Les-opossums/ELE_PAMI_2027/3D/PAMI_2026_B1.step

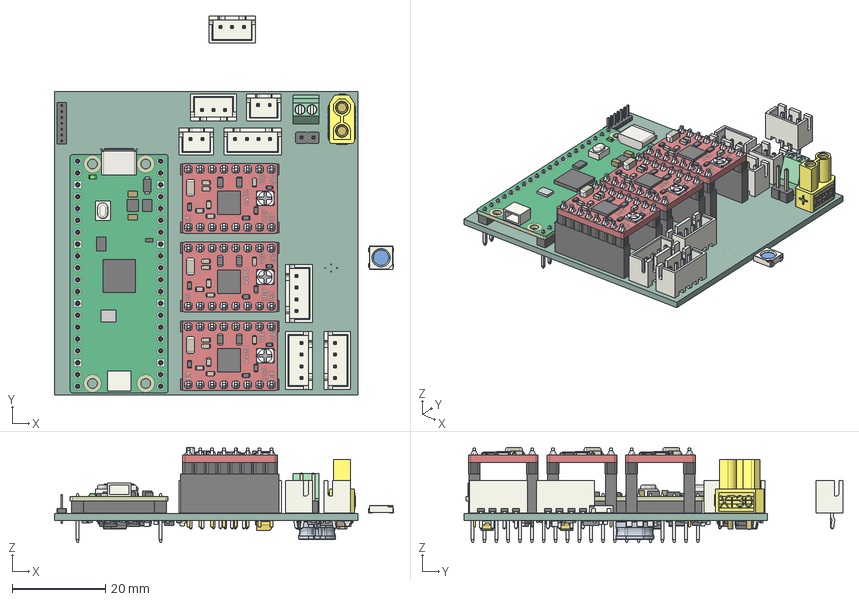
[picture p4: CAD file, 2026-11-06]
3D/PAMI_2026_B1.step
72.7 x 81.2 x 20.4 mm
PinHeader_1x07_P1.27mm_Vertical
XT30-F_m.ver
JST_XH_B4B-XH-A_1x04_P2.50mm_Vertical x 4
A4988-Stepper-Driver-Socketed x 3
JST_XH_B2B-XH-A_1x02_P2.50mm_Vertical x 2
TerminalBlock_Phoenix_MPT-0,5-2-2.54_1x02_P2.54mm_Horizontal
LED_WS2812B_PLCC4_5.0x5.0mm_P3.2mm
RaspberryPi_Pico_H_Module_KiCad
RaspberryPi_Pico_Header_DIP-40_H2.54mm_KiCad
PinHeader_1x02_P2.54mm_Vertical
JST_XH_B3B-XH-A_1x03_P2.50mm_Vertical x 2
MOLD x 2
C_CASE-B-3528-21(mm) x 3
C_0805 x 6
R_0402 x 40
R_0603 x 7
C_0603 x 5
C_0402 x 9
SMAF_L3.5-W2.6-LS4.7-RD
Q_SOT-23 x 5
LED_0603_1608Metric x 4
BODY-QFN
PIN1-ID
SRN8040
SOIC-8_3.9x4.9mm_P1.27mm
SOT-223_L6.5-W3.5-P2.30-LS7.0-BR
PAMI_2026_B1_PCB
