Les-opossums/ELE_PAMI_2027/_Design/WBDesign15.pdf

## WEBENCH ® Design Report

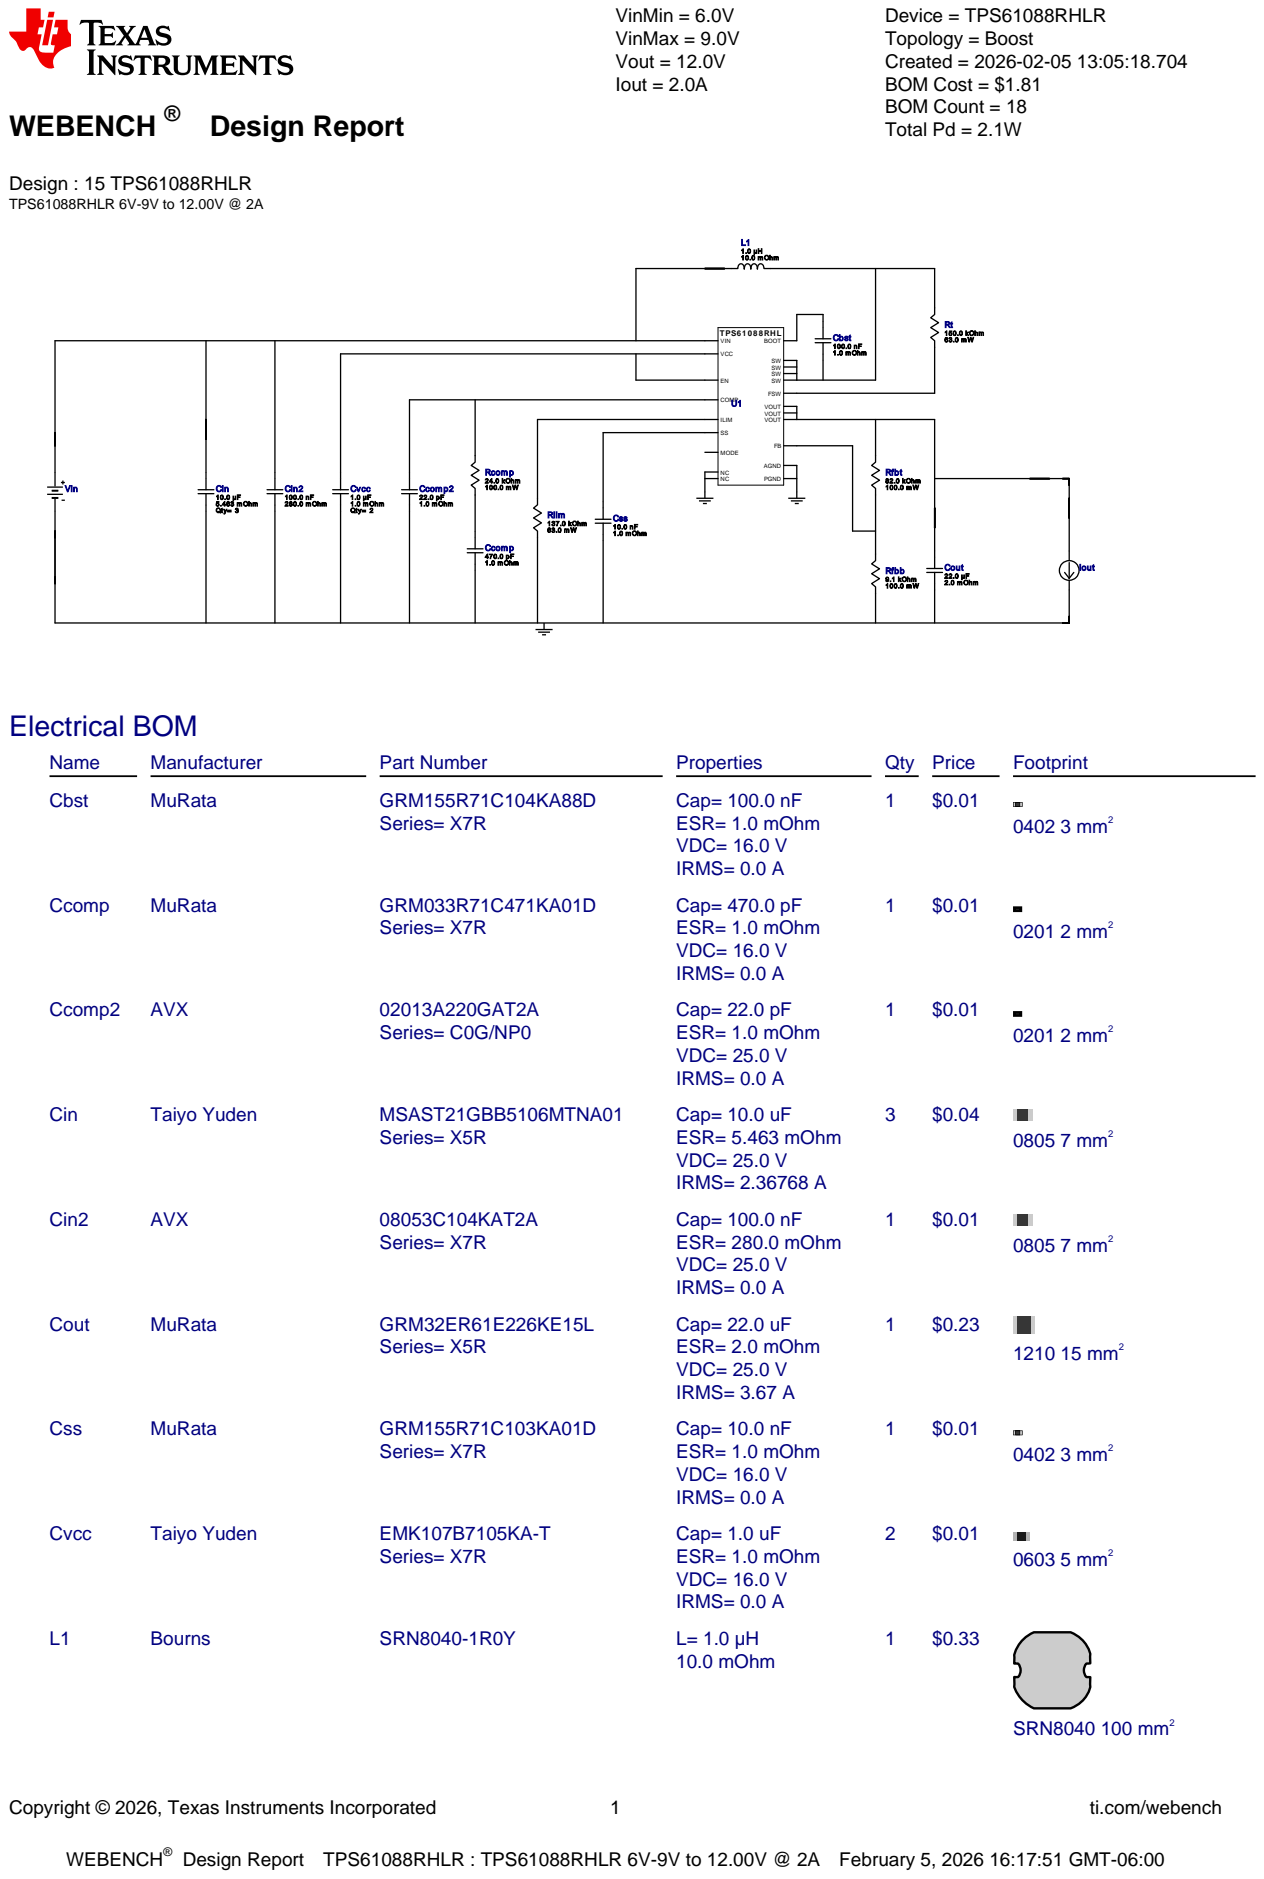
[picture p5: page 1]
Copyright © 2026, Texas Instruments Incorporated; ti.com/webench; WEBENCH®; Design : 15 TPS61088RHLR TPS61088RHLR 6V-9V to 12.00V @ 2A; VinMin = 6.0V VinMax = 9.0V Vout = 12.0V Iout = 2.0A; Device = TPS61088RHLR Topology = Boost Created = 2026-02-05 13:05:18.704 BOM Cost = $1.81 BOM Count = 18 Total Pd = 2.1W; Rlim 137.0 kOhm 63.0 m W; Ccom p 470.0 pF 1.0 m Ohm; Cin2 100.0 nF 280.0 m Ohm; TPS6 1 0 8 8 RHL; VCC; FSW; VIN; BOOT; MODE; VOUT VOUT VOUT; COMP; ILIM; AGND; PGND; Rfbt 82.0 kOhm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

Design Report TPS61088RHLR : TPS61088RHLR 6V-9V to 12.00V @ 2A February 5, 2026 16:17:51 GMT-06:00

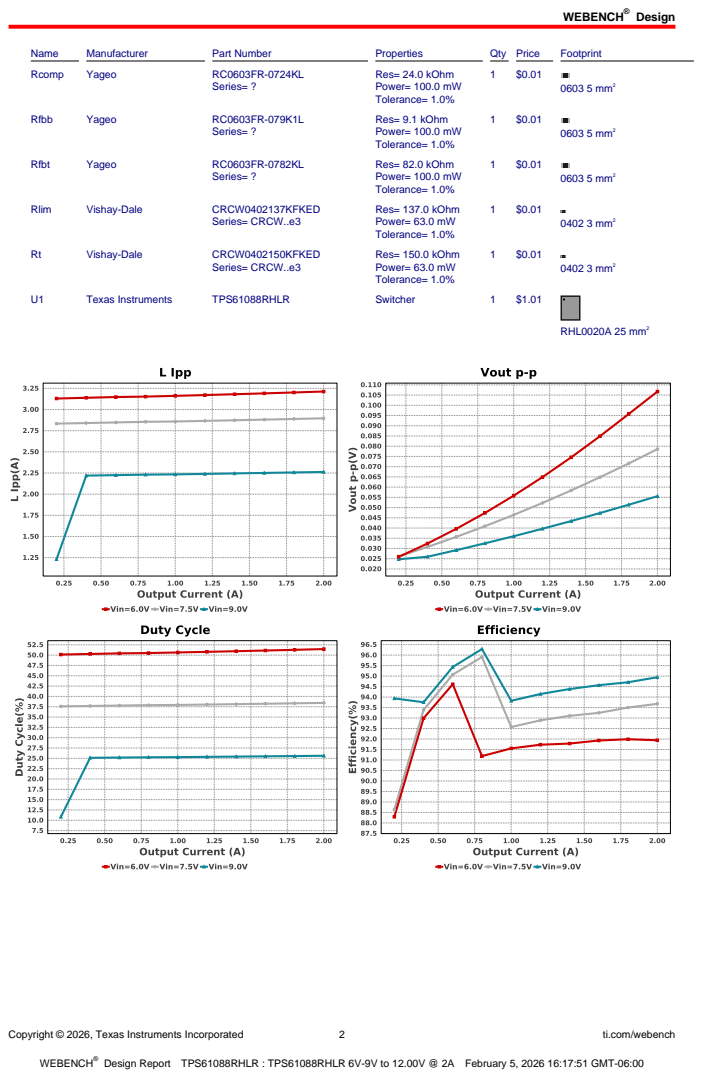
[picture p6: page 2]
Design; Copyright © 2026, Texas Instruments Incorporated; ti.com/webench; Name; Manufacturer; Part Number; Properties; Qty Price; Footprint; Rcomp; Yageo; Series= ?; Res= 24.0 kOhm Power= 100.0 mW Tolerance= 1.0%; 0603 5 mm²; Rfbb; Res= 9.1 kOhm Power= 100.0 mW Tolerance= 1.0%; Rfbt; Res= 82.0 kOhm Power= 100.0 mW Tolerance= 1.0%; Rlim; Vishay-Dale; CRCW0402137KFKED; Series= CRCW..e3; Res= 137.0 kOhm Power= 63.0 mW Tolerance= 1.0%; 0402 3 mm²; CRCW0402150KFKED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

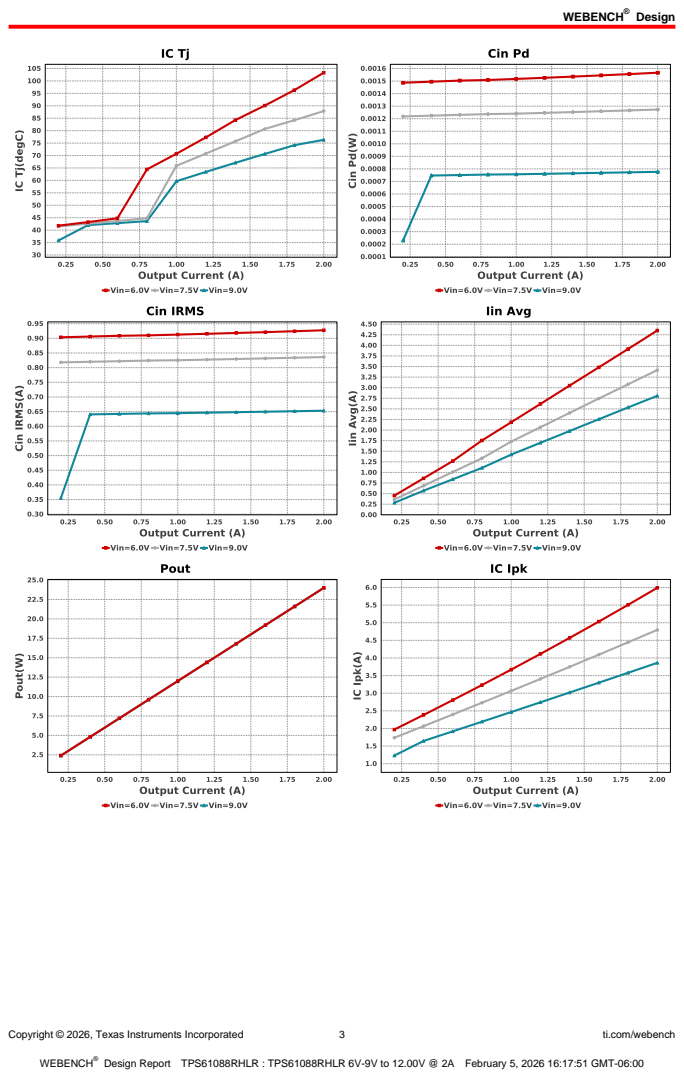
[picture p7: page 3]
Copyright © 2026, Texas Instruments Incorporated; ti.com/webench

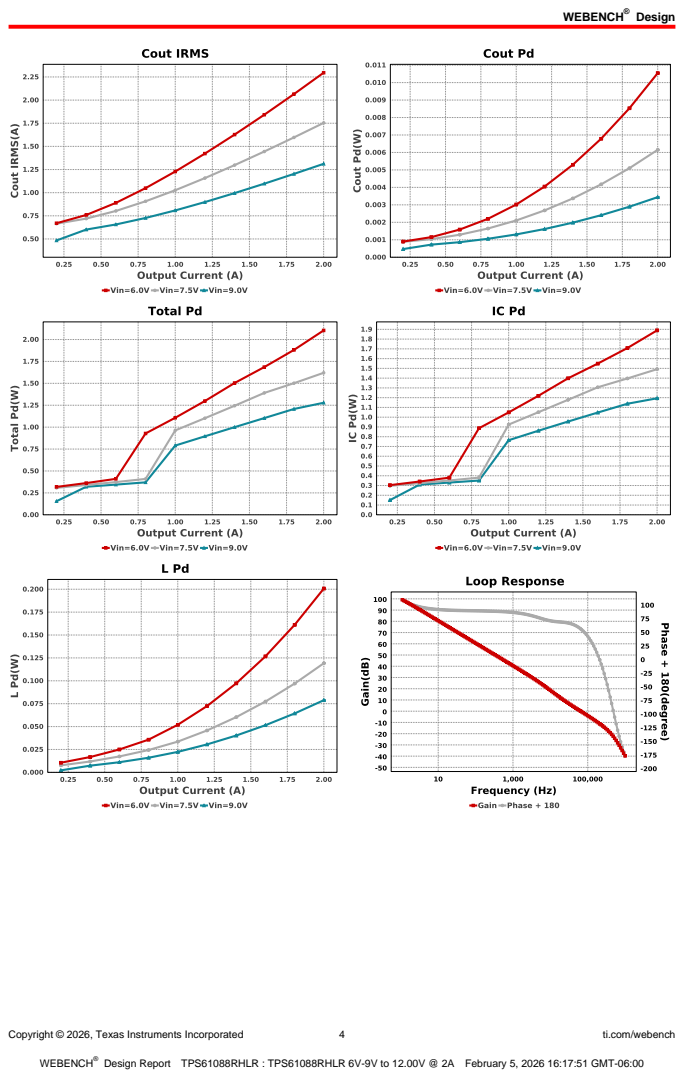
[picture p8: page 4]
Copyright © 2026, Texas Instruments Incorporated; ti.com/webench

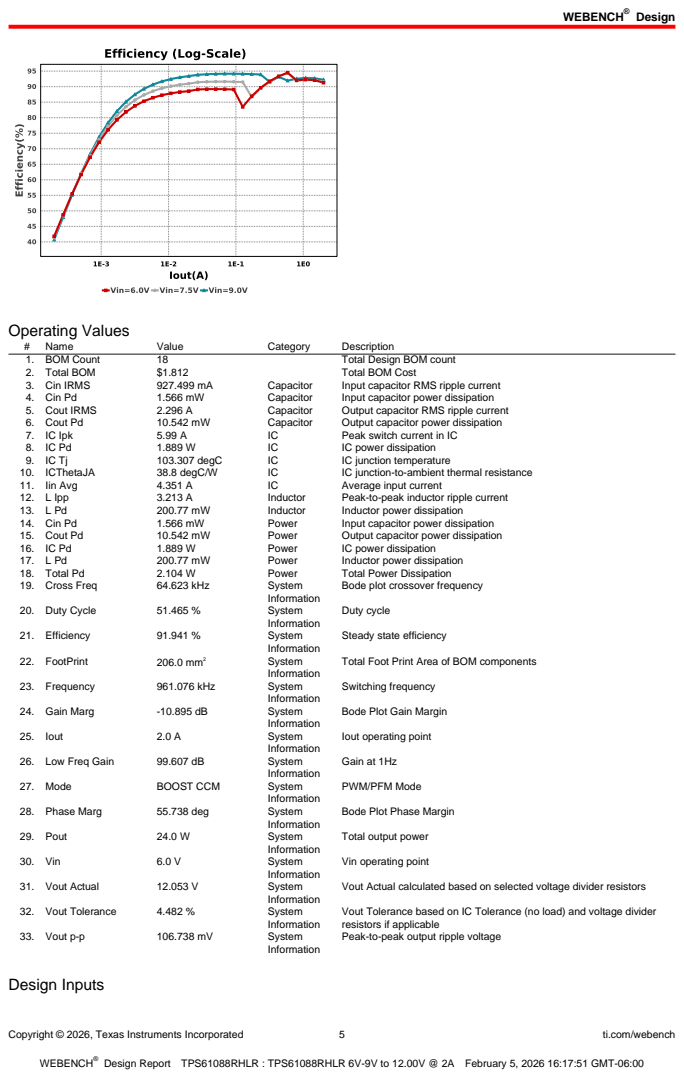
[picture p9: page 5]
Copyright © 2026, Texas Instruments Incorporated; ti.com/webench; Operating Values; Name; Value; Category; Description; 1. BOM Count; Total Design BOM count; 2. Total BOM; Total BOM Cost; 3. Cin IRMS; Capacitor; Input capacitor RMS ripple current; 4. Cin Pd; Input capacitor power dissipation; 5. Cout IRMS; Output capacitor RMS ripple current; 6. Cout Pd; Output capacitor power dissipation; 7. IC Ipk; Peak switch current in IC; IC power dissipation; 103.307 degC; IC junction temperature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

Bode plot crossover frequency

Steady state efficiency

Total Foot Print Area of BOM components

Bode Plot Gain Margin

Iout operating point

PWM/PFM Mode

Bode Plot Phase Margin

Total output power

Vin operating point

Vout Actual calculated based on selected voltage divider resistors

Vout Tolerance based on IC Tolerance (no load) and voltage divider
resistors if applicable
Peak-to-peak output ripple voltage

Copyright © 2026, Texas Instruments Incorporated | 6 | ti.com/webench
Name | Value | Description
Iout | 2.0 | Maximum Output Current
SoftStart | 2.41 ms | Soft Start Time (ms)
VinMax | 9.0 | Maximum input voltage
VinMin | 6.0 | Minimum input voltage
Vout | 12.0 | Output Voltage
base_pn | TPS61088 | Base Product Number
source | DC | Input Source Type
Ta | 30.0 | Ambient temperature
UserFsw | 961.0 k | Customer Selected Frequency


Copyright © 2026, Texas Instruments Incorporated | 7 | ti.com/webench

## Assembly

## Component Testing

Some published data on components in datasheets such as Capacitor ESR and Inductor DC resistance is based on conservative values that will guarantee that the components always exceed the specification. For design purposes it is usually better to work with typical values. Since this data is not always available it is a good practice to measure the Capacitance and ESR values of Cin and Cout, and the inductance and DC resistance of L1 before assembly of the board. Any large discrepancies in values should be electrically simulated in WEBENCH to check for instabilities and thermally simulated in WebTHERM to make sure critical temperatures are not exceeded.

## Soldering Component to Board

If board assembly is done in house it is best to tack down one terminal of a component on the board then solder the other terminal. For surface mount parts with large tabs, such as the DPAK, the tab on the back of the package should be pre-tinned with solder, then tacked into place by one of the pins. To solder the tab town to the board place the iron down on the board while resting against the tab, heating both surfaces simultaneously. Apply light pressure to the top of the plastic case until the solder flows around the part and the part is flush with the PCB. If the solder is not flowing around the board you may need a higher wattage iron (generally 25W to 30W is enough).

## Initial Startup of Circuit

It is best to initially power up the board by setting the input supply voltage to the lowest operating input voltage 6.0V and set the input supply's current limit to zero. With the input supply off connect up the input supply to Vin and GND. Connect a digital volt meter and a load if needed to set the minimum Iout of the design from Vout and GND. Turn on the input supply and slowly turn up the current limit on the input supply. If the voltage starts to rise on the input supply continue increasing the input supply current limit while watching the output voltage. If the current increases on the input supply, but the voltage remains near zero, then there may be a short or a component misplaced on the board. Power down the board and visually inspect for solder bridges and recheck the diode and capacitor polarities. Once the power supply circuit is operational then more extensive testing may include full load testing, transient load and line tests to compare with simulation results.

## Load Testing

The setup is the same as the initial startup, except that an additional digital voltmeter is connected between Vin and GND, a load is connected between Vout and GND and a current meter is connected in series between Vout and the load. The load must be able to handle at least rated output power + 50% ( 7.5 watts for this design). Ideally the load is supplied in the form of a variable load test unit. It can also be done in the form of suitably large power resistors. When using an oscilloscope to measure waveforms on the prototype board, the ground leads of the oscilloscope probes should be as short as possible and the area of the loop formed by the ground lead should be kept to a minimum. This will help reduce ground lead inductance and eliminate EMI noise that is not actually present in the circuit.

## Design Assistance

1. Master key : A334E1D4DAA32D88[v1]
2. TPS61088 Product Folder : http://www.ti.com/product/TPS61088 : contains the data sheet and other resources.

Copyright © 2026, Texas Instruments Incorporated | 8 | ti.com/webench

Important Notice and Disclaimer

TI provides technical and reliability data (including datasheets), design resources (including reference designs), application or other design advice, web tools, safety information, and other resources AS IS and with all faults, and disclaims all warranties. These resources are intended for skilled developers designing with TI products. You are solely responsible for (1) selecting the appropriate TI products for your application, (2) designing, validating and testing your application, and (3) ensuring your application meets applicable standards, and any other safety, security, or other requirements.

These resources are subject to change without notice. TI grants you permission to use these resources only for development of an application that uses the TI products described in the resource. Other reproduction and display of these resources is prohibited. No license is granted to any other TI intellectual property right or to any third party intellectual property right. TI disclaims responsibility for, and you will fully indemnify TI and its representatives against, any claims, damages, costs, losses, and liabilities arising out of your use of these resources.

Providing these resources does not expand or otherwise alter TI's applicable Terms of Sale or other applicable terms available either on ti.com or provided in conjunction with TI products.
