Les-opossums/ELE_PAMI_2027/PAMI_2027_A1.pdf

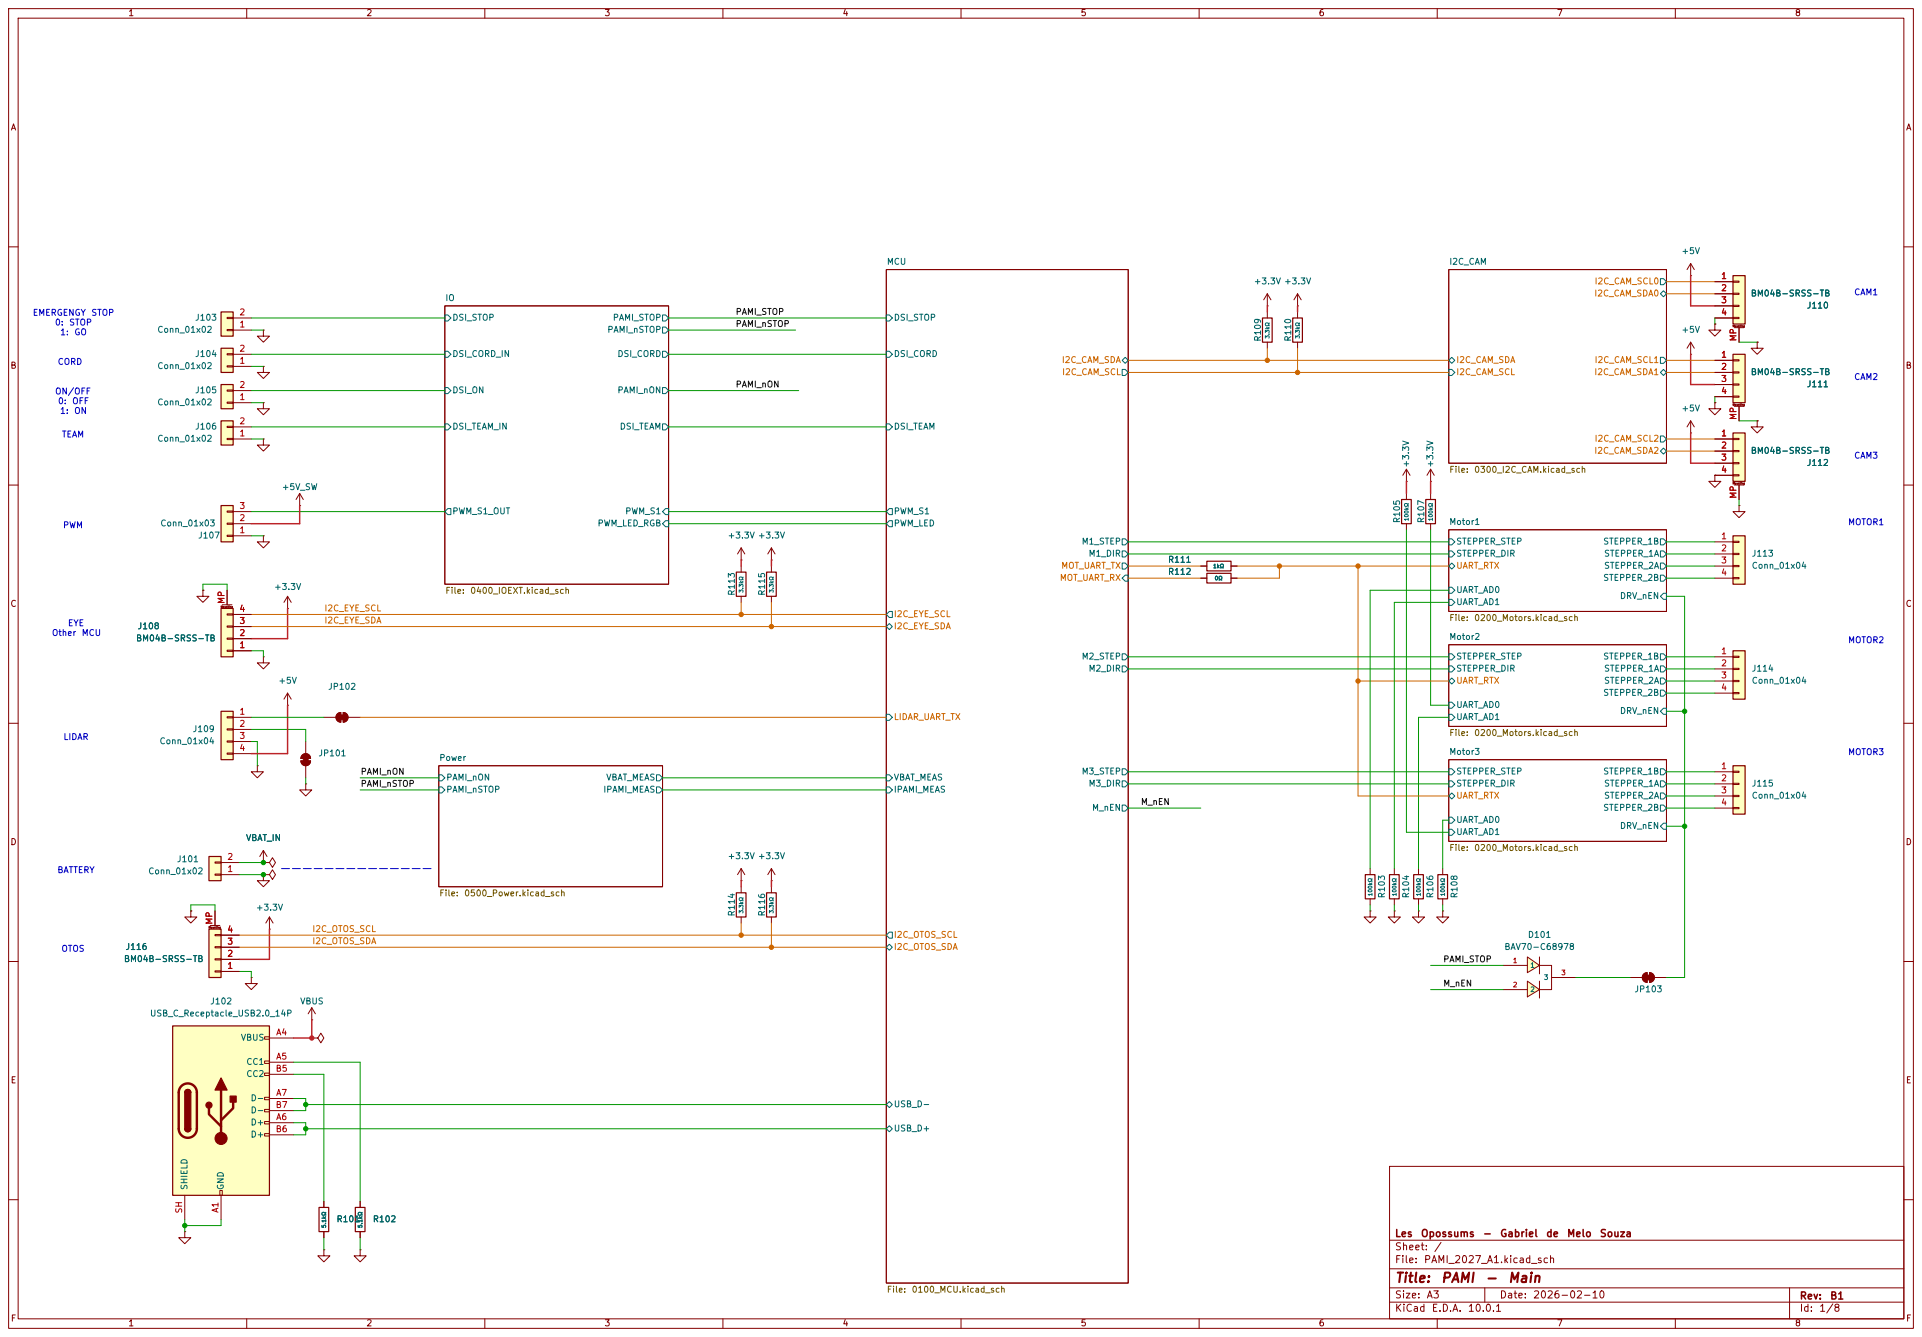
[picture p11: page 1]

1 | PAMI_nON | +3.3V 1

2 2
3 3

Les Opossums - Gabriel de Melo Souza
Sheet: /
File: PAMI_2027_A1.kicad_sch
Title: PAMI - Main

Size: A3 | Rev: B1 | F Date: 2026-02-10
KiCad E.D.A. 10.0.1 | Id: 1/8

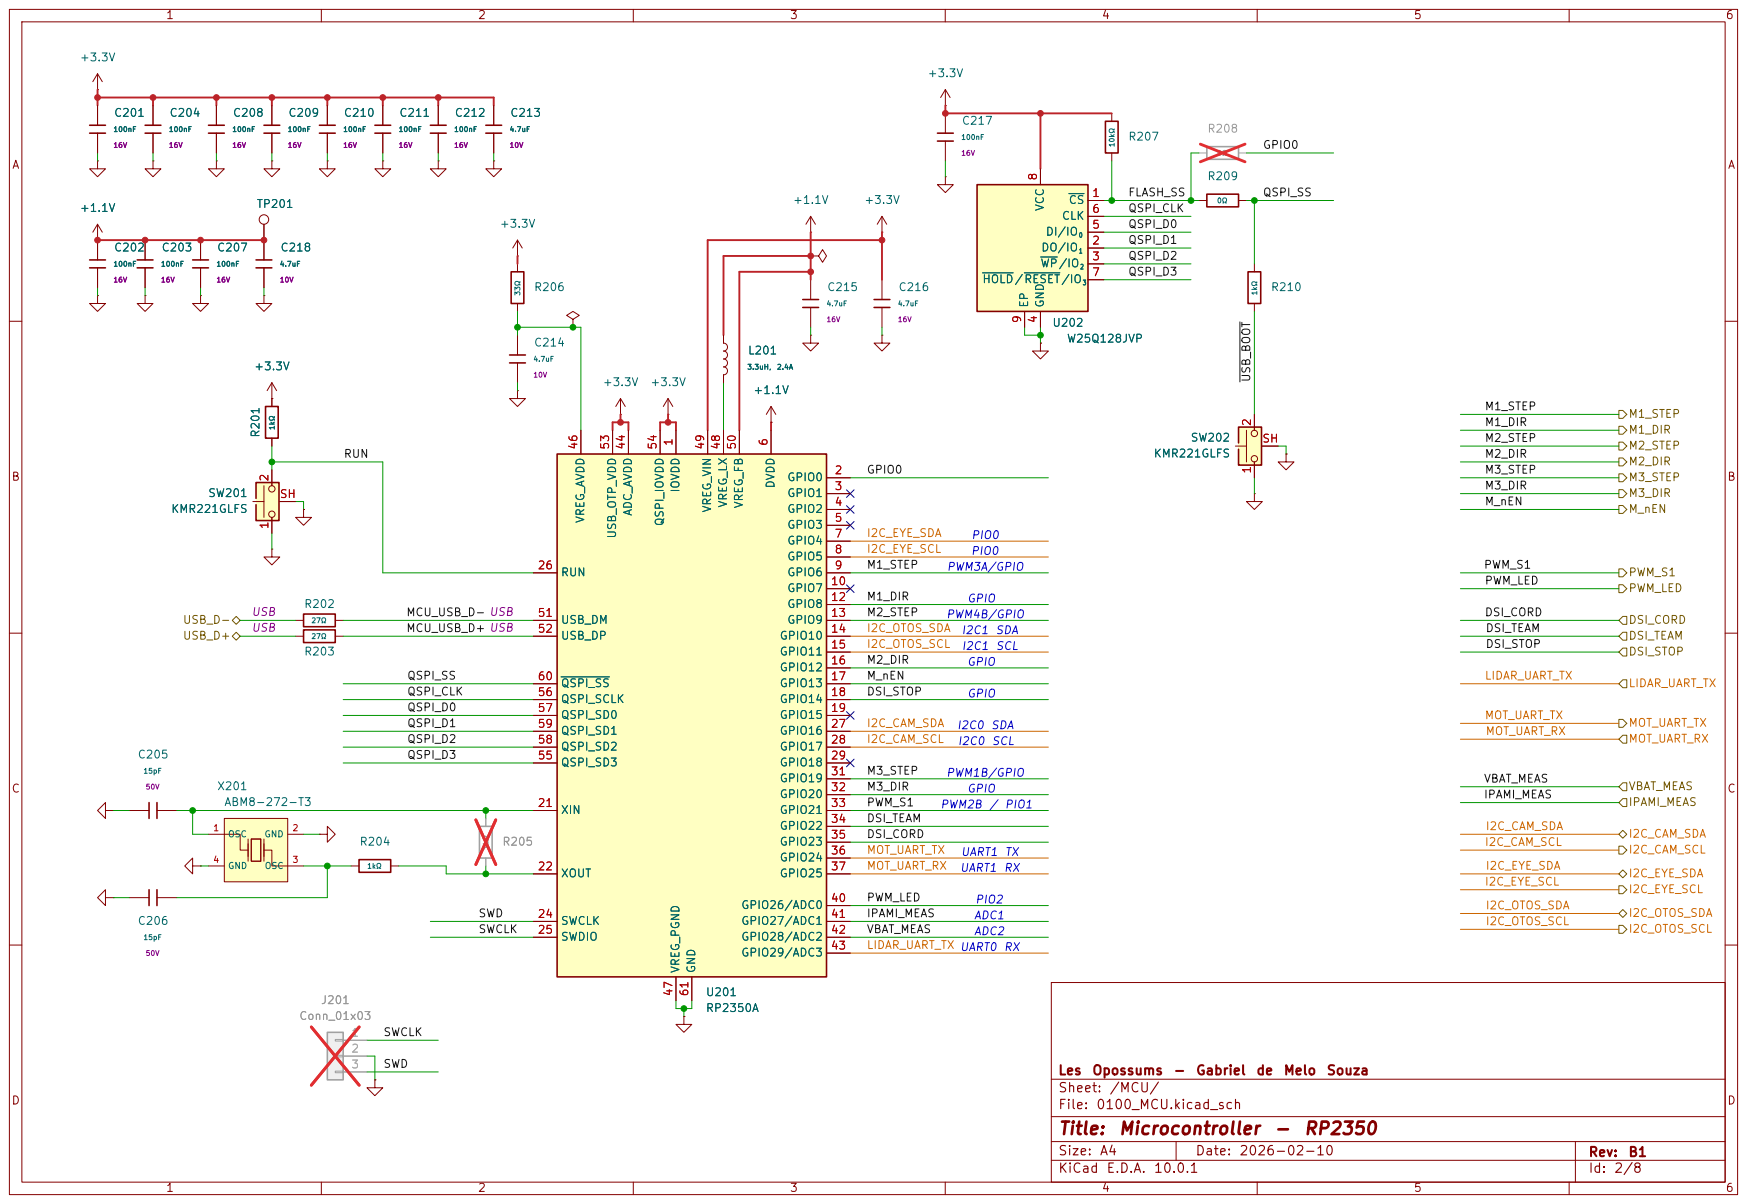
[picture p12: page 2]

4 DI/IO0 5 CLK 6 HOLD/RESET/IO3 7 VCC

XIN 21

XOUT 22 XOUT 22 SWCLK 24 SWCLK 24

Les Opossums - Gabriel de Melo Souza
Sheet: /MCU/
File: 0100_MCU.kicad_sch
Title: Microcontroller - RP2350

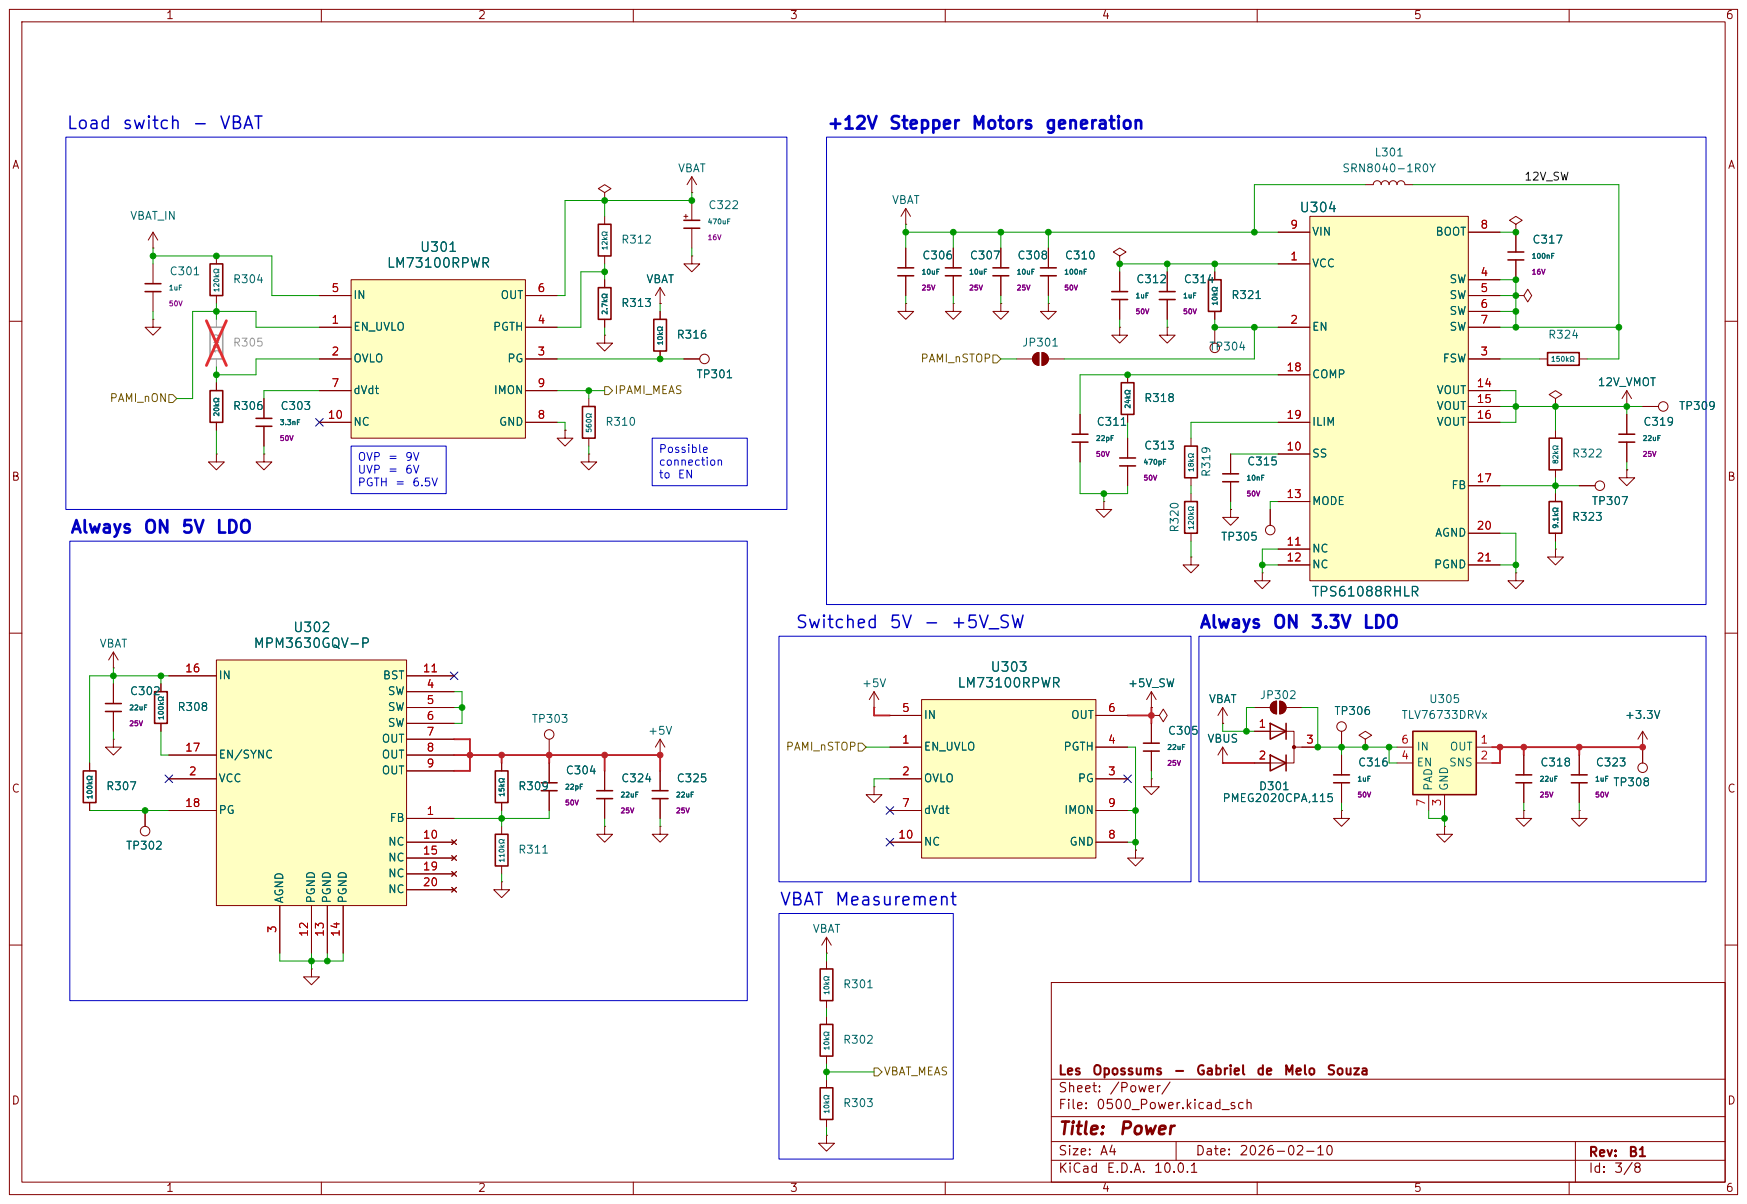
[picture p13: page 3]

VCC 1

to EN Always ON 5V LDO

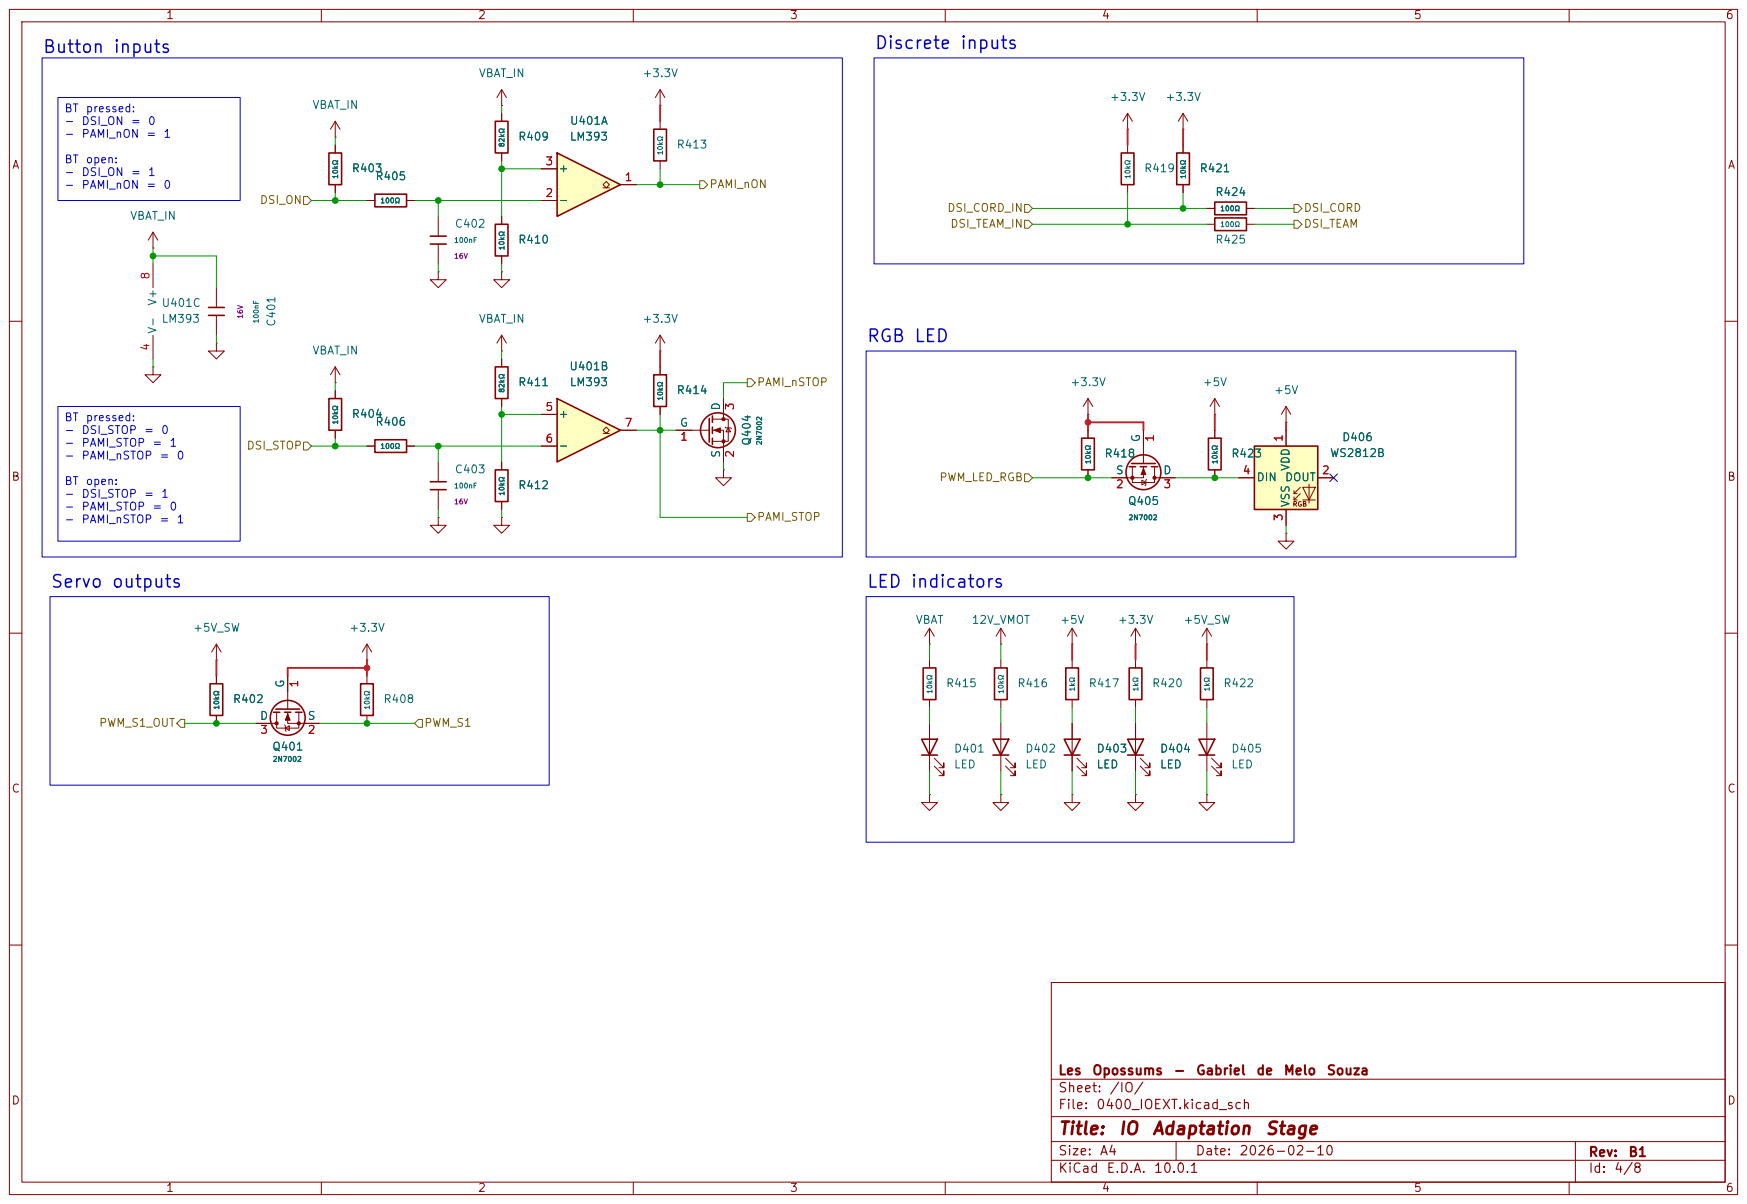
[picture p14: page 4]

Sheet: /IO/
File: 0400_IOEXT.kicad_sch
Title: IO Adaptation Stage

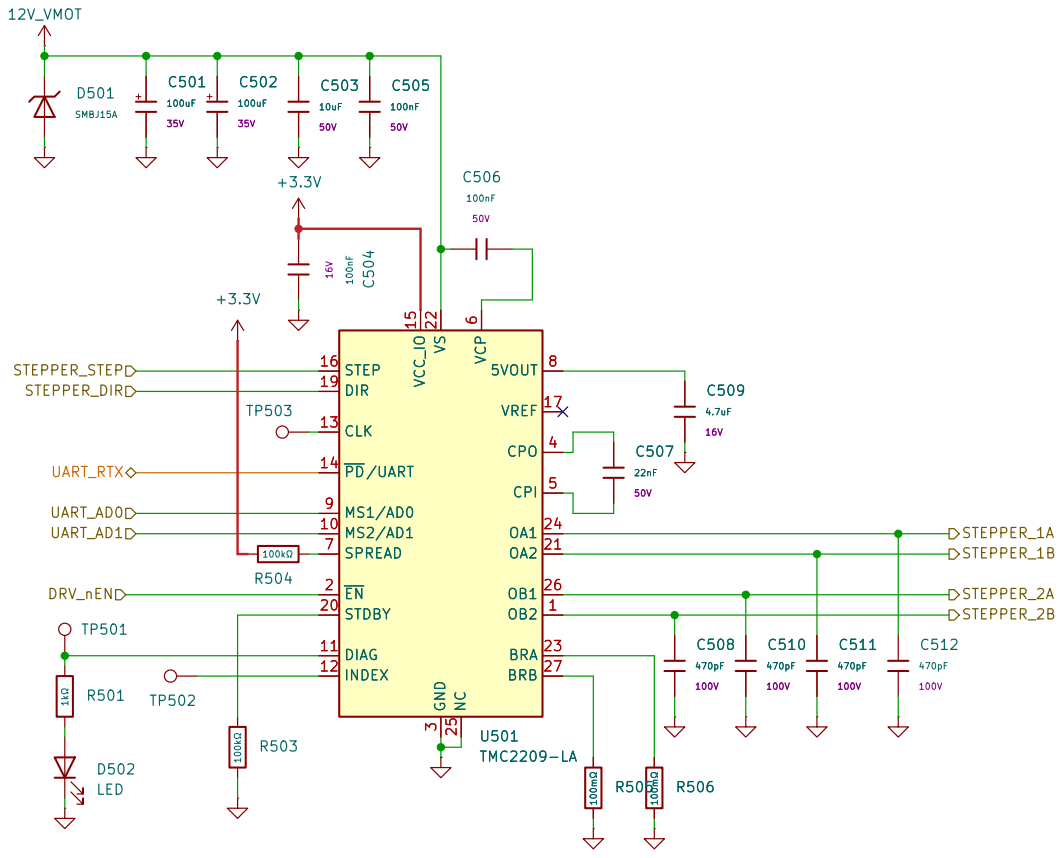
[picture p15: page 5]

Les Opossums - Gabriel de Melo Souza
Sheet: /Motor1/
File: 0200_Motors.kicad_sch
Title: Stepper Motor

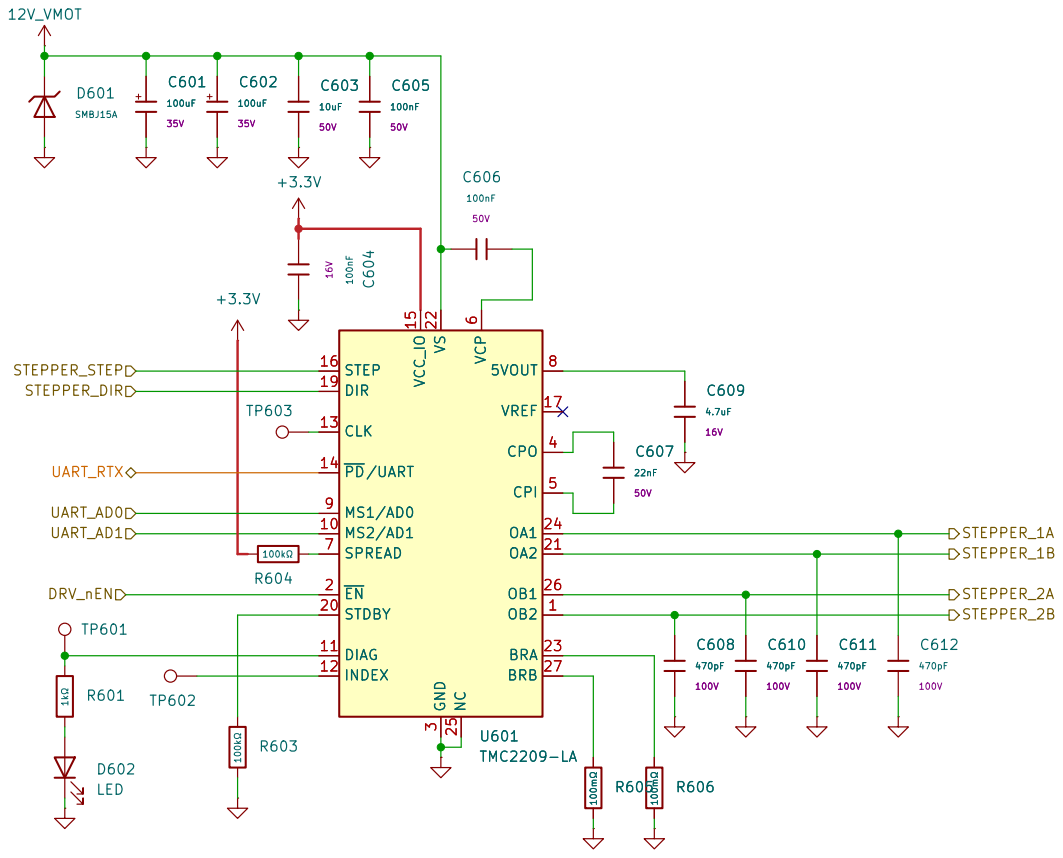
[picture p16: page 6]

Les Opossums - Gabriel de Melo Souza
Sheet: /Motor2/
File: 0200_Motors.kicad_sch
Title: Stepper Motor

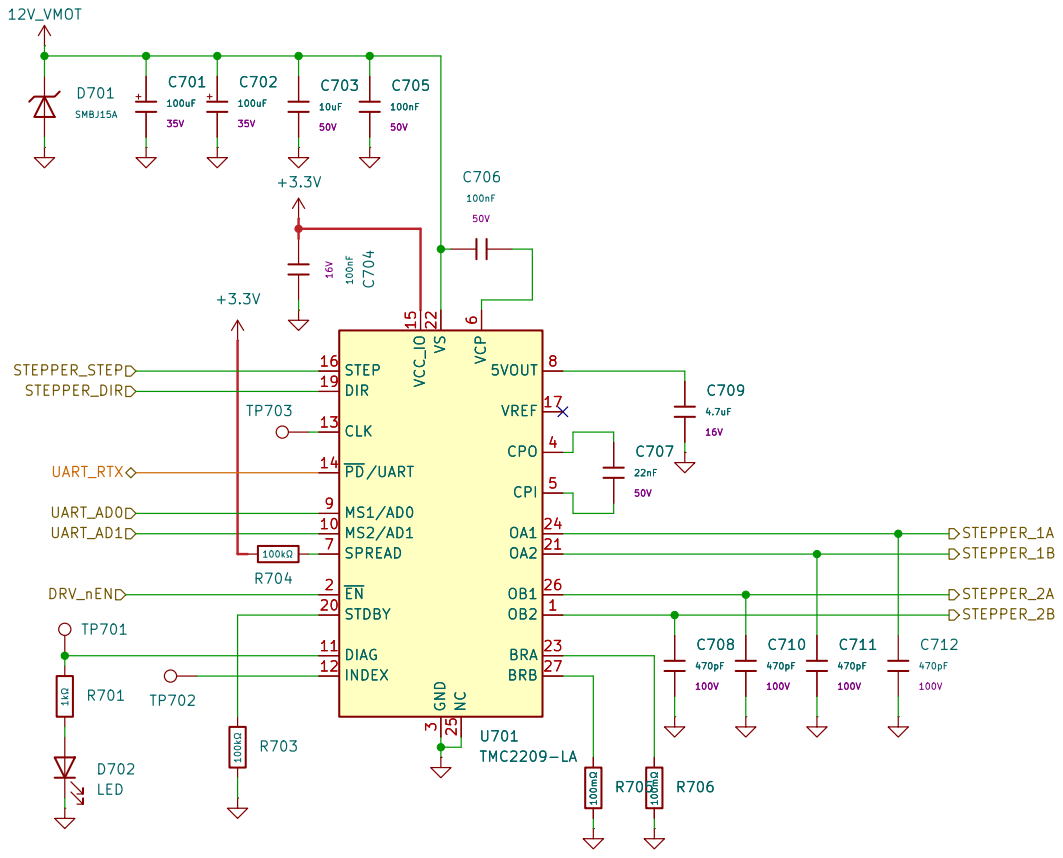
[picture p17: page 7]

Les Opossums - Gabriel de Melo Souza
Sheet: /Motor3/
File: 0200_Motors.kicad_sch
Title: Stepper Motor

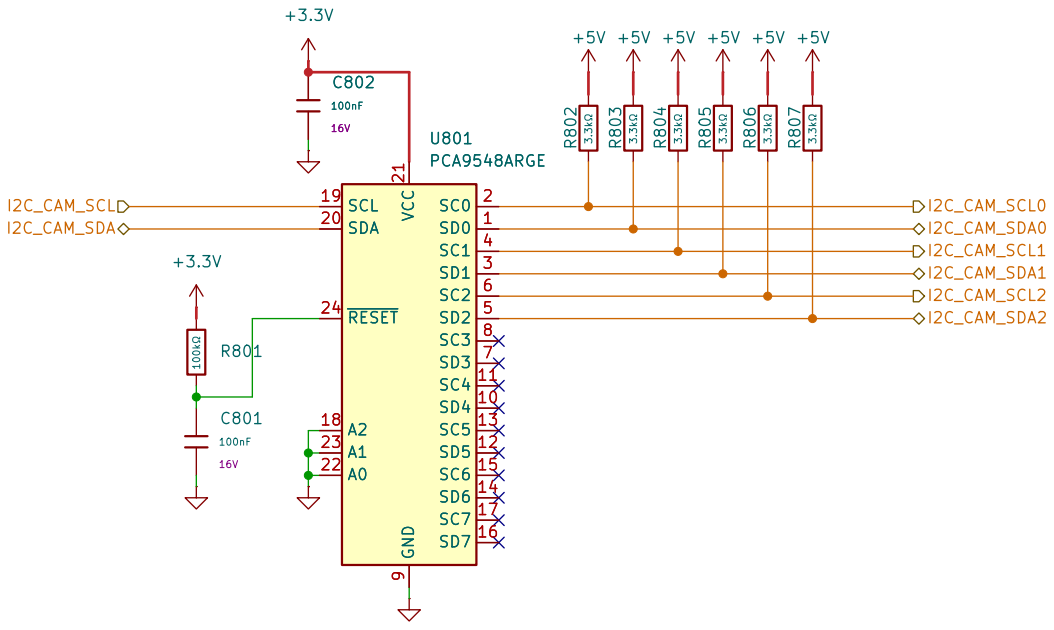
[picture p18: page 8]
