Les-opossums/ELE_PAMI_2027/PAMI_2027_A1.kicad_pcb

## KiCad design PAMI_2027_A1.kicad_pcb (2026-11-06)

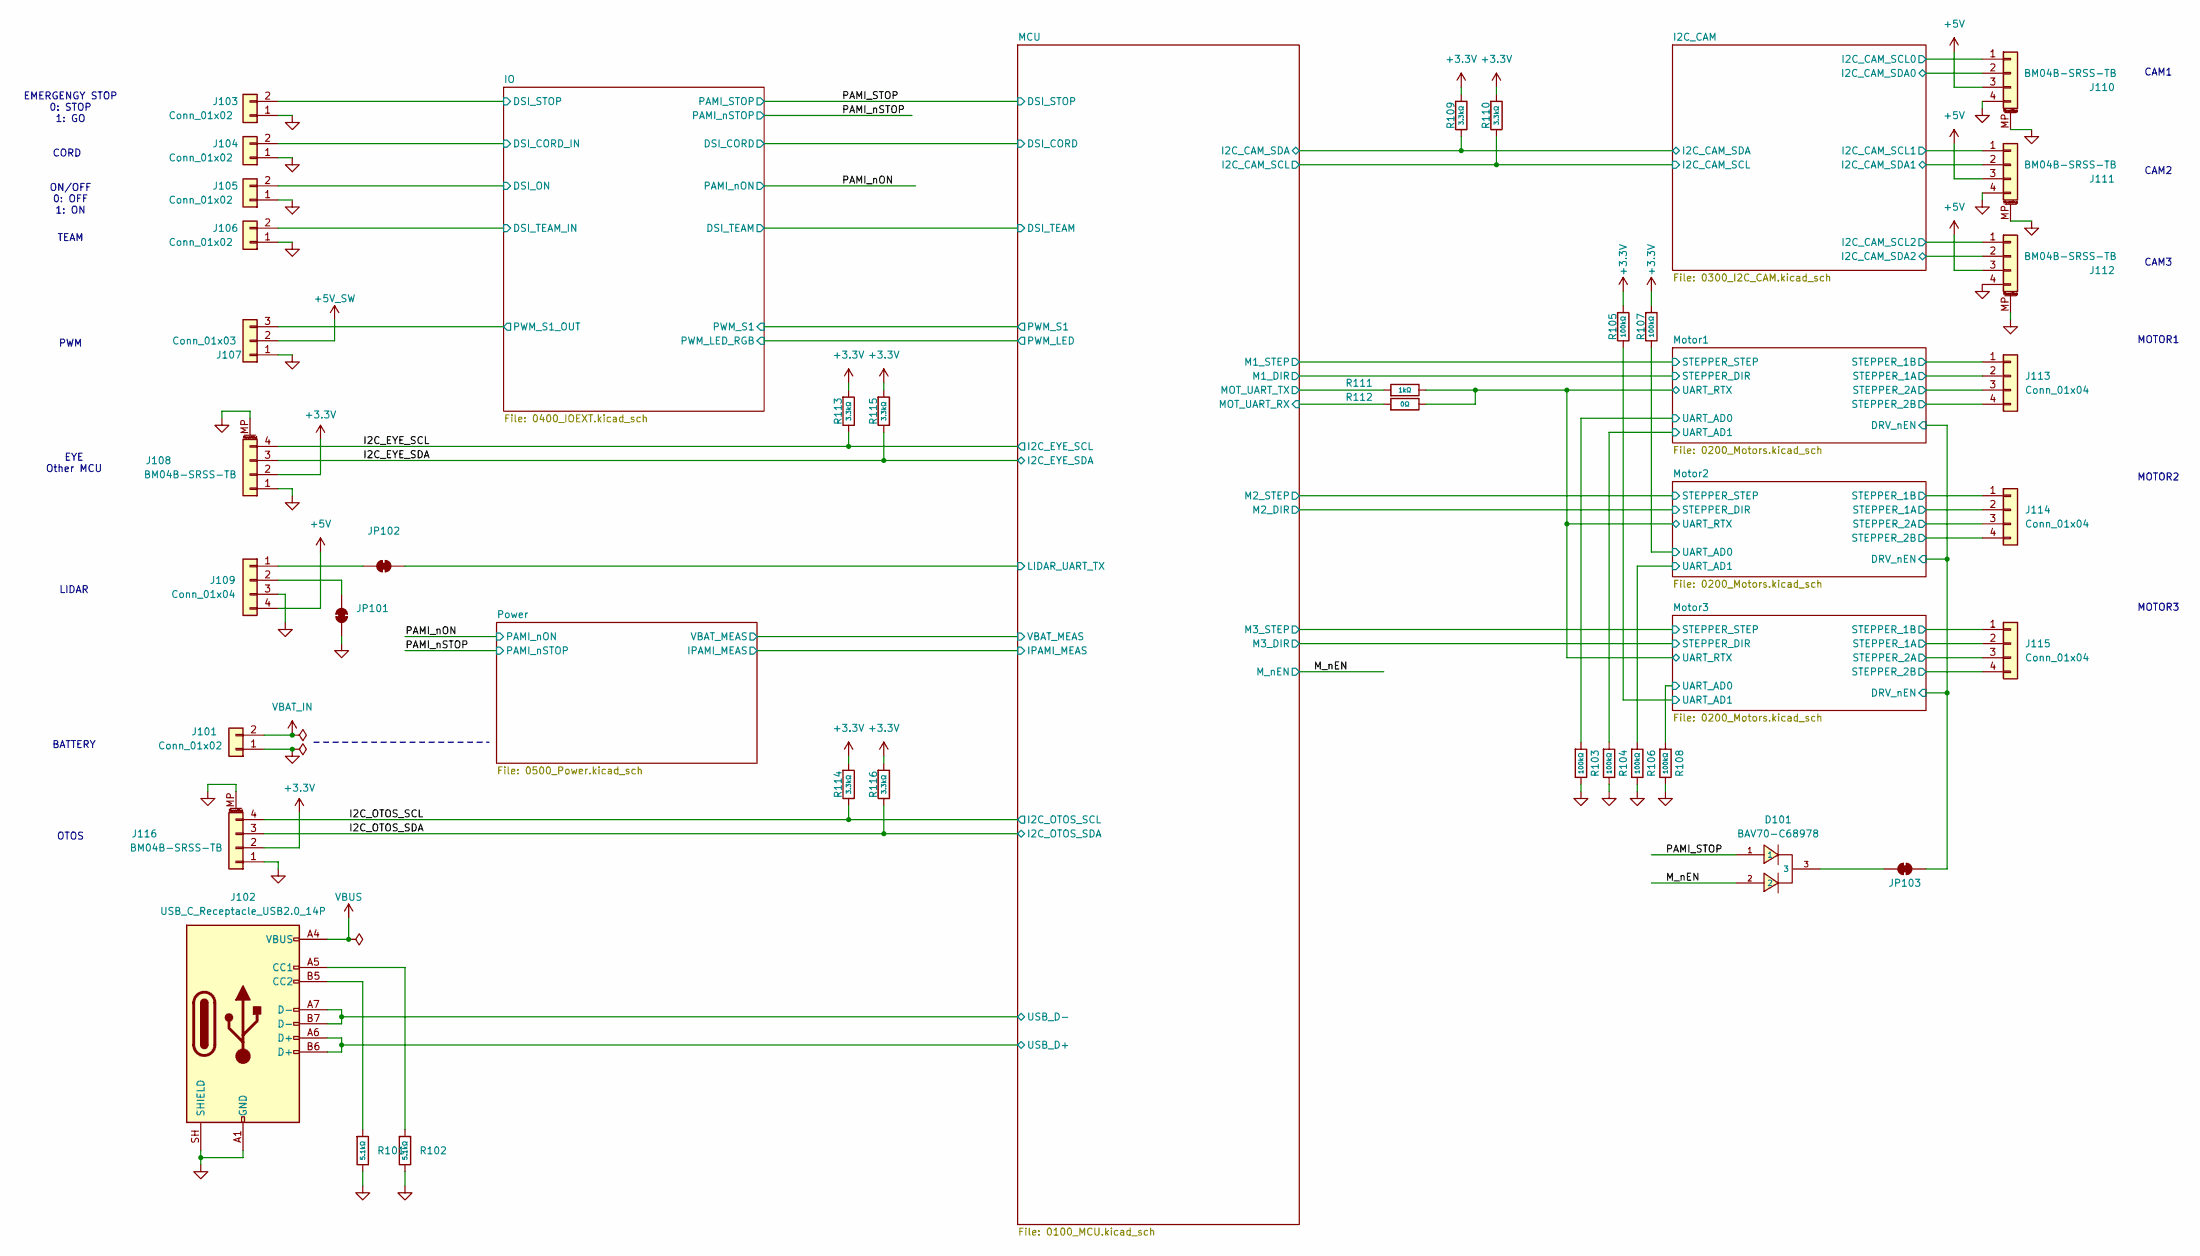
[picture p19: schematic PAMI_2027_A1.kicad_sch, PAMI - Main]

Parts:
D101: BAV70-C68978; SOT-23-3_L3.0-W1.7-P0.95-LS2.9-BR; Reverse Voltage (Vr) 70V; Forward Voltage (Vf@If) 1.25V@150mA; Part BAV70; LCSC C68978
J101: Conn_01x02; AMASS_XT30U-F_1x02_P5.0mm_Vertical
J102: USB_C_Receptacle_USB2.0_14P; USB_C_Receptacle_GCT_USB4105-xx-A_16P_TopMnt_Horizontal
J103, J104, J105, J106: Conn_01x02; JST_XH_B2B-XH-A_1x02_P2.50mm_Vertical
J107: Conn_01x03; JST_XH_B3B-XH-A_1x03_P2.50mm_Vertical
J108, J110, J111, J112, J116: BM04B-SRSS-TB; JST_SH_BM04B-SRSS-TB_1x04-1MP_P1.00mm_Vertical; JLCPCB Part # C160390
J109, J113, J114, J115: Conn_01x04; JST_XH_B4B-XH-A_1x04_P2.50mm_Vertical
JP101, JP102, JP103: SolderJumper_2_Bridged; SolderJumper-2_P1.3mm_Bridged_RoundedPad1.0x1.5mm
R101, R102: 5.1kΩ; R_0402; Overload Voltage (Max) 50V; Tolerance ±1%; Part 0402WGF5101TCE; LCSC C25905
R103, R104, R105, R106, R107, R108: 100kΩ; R_0402; Overload Voltage (Max) 50V; Tolerance ±1%; Part 0402WGF1003TCE; LCSC C25741
R109, R110, R113, R114, R115, R116: 3.3kΩ; R_0402; Overload Voltage (Max) 50V; Tolerance ±1%; Part 0402WGF3301TCE; LCSC C25890
R111: 1kΩ; R_0402; Overload Voltage (Max) 50V; Tolerance ±1%; Part 0402WGF1001TCE; LCSC C11702
R112: 0Ω; R_0402; Overload Voltage (Max) 50V; Tolerance ±1%; Part 0402WGF0000TCE; LCSC C17168

Connections:
+3.3V: J108.2, J116.2, R105.1, R107.1, R109.1, R110.1, R113.1, R114.1, R115.1, R116.1; also elsewhere on the board
+5V: J109.4, J110.3, J111.3, J112.3; also elsewhere on the board
+5V_SW: J107.2; also elsewhere on the board
/I2C_CAM/I2C_CAM_SCL0: J110.1; also elsewhere on the board
/I2C_CAM/I2C_CAM_SCL1: J111.1; also elsewhere on the board
/I2C_CAM/I2C_CAM_SCL2: J112.1; also elsewhere on the board
/I2C_CAM/I2C_CAM_SDA0: J110.2; also elsewhere on the board
/I2C_CAM/I2C_CAM_SDA1: J111.2; also elsewhere on the board
/I2C_CAM/I2C_CAM_SDA2: J112.2; also elsewhere on the board
/I2C_EYE_SCL: J108.4, R113.2; also elsewhere on the board
/I2C_EYE_SDA: J108.3, R115.2; also elsewhere on the board
/I2C_OTOS_SCL: J116.4, R114.2; also elsewhere on the board
/I2C_OTOS_SDA: J116.3, R116.2; also elsewhere on the board
/IO/DSI_CORD_IN: J104.2; also elsewhere on the board
/IO/DSI_ON: J105.2; also elsewhere on the board
/IO/DSI_STOP: J103.2; also elsewhere on the board
/IO/DSI_TEAM_IN: J106.2; also elsewhere on the board
/IO/PWM_S1_OUT: J107.3; also elsewhere on the board
/MCU/I2C_CAM_SCL: R110.2; also elsewhere on the board
/MCU/I2C_CAM_SDA: R109.2; also elsewhere on the board
/MCU/LIDAR_UART_TX: JP102.1 (A); also elsewhere on the board
/MCU/MOT_UART_RX: R112.1; also elsewhere on the board
/MCU/MOT_UART_TX: R111.1; also elsewhere on the board
/MCU/USB_D+: J102.A6 (D+), J102.B6 (D+); also elsewhere on the board
/MCU/USB_D-: J102.A7 (D-), J102.B7 (D-); also elsewhere on the board
/M_nEN: D101.2; also elsewhere on the board
/Motor1/DRV_nEN: JP103.1 (A); also elsewhere on the board
/Motor1/STEPPER_1A: J113.2; also elsewhere on the board
/Motor1/STEPPER_1B: J113.1; also elsewhere on the board
/Motor1/STEPPER_2A: J113.3; also elsewhere on the board
/Motor1/STEPPER_2B: J113.4; also elsewhere on the board
/Motor1/UART_AD0: R103.1; also elsewhere on the board
/Motor1/UART_AD1: R104.1; also elsewhere on the board
/Motor1/UART_RTX: R111.2, R112.2; also elsewhere on the board
/Motor2/STEPPER_1A: J114.2; also elsewhere on the board
/Motor2/STEPPER_1B: J114.1; also elsewhere on the board
/Motor2/STEPPER_2A: J114.3; also elsewhere on the board
/Motor2/STEPPER_2B: J114.4; also elsewhere on the board
/Motor2/UART_AD0: R107.2; also elsewhere on the board
/Motor2/UART_AD1: R106.1; also elsewhere on the board
/Motor3/STEPPER_1A: J115.2; also elsewhere on the board
/Motor3/STEPPER_1B: J115.1; also elsewhere on the board
/Motor3/STEPPER_2A: J115.3; also elsewhere on the board
/Motor3/STEPPER_2B: J115.4; also elsewhere on the board
/Motor3/UART_AD0: R108.1; also elsewhere on the board
/Motor3/UART_AD1: R105.2; also elsewhere on the board
/PAMI_STOP: D101.1; also elsewhere on the board
GND: J101.1, J102.A1 (GND), J102.A12 (GND), J102.B1 (GND), J102.B12 (GND), J102.SH (SHIELD), J103.1, J104.1, J105.1, J106.1, J107.1, J108.1, J108.MP (MountPin), J109.3, J110.4, J110.MP (MountPin), J111.4, J111.MP (MountPin), J112.4, J112.MP (MountPin), J116.1, J116.MP (MountPin), JP101.1 (A), R101.2, R102.2, R103.2, R104.2, R106.2, R108.2; also elsewhere on the board
unnamed: J102.A5 (CC1), R102.1
unnamed: J102.B5 (CC2), R101.1
unnamed: J109.1, JP102.2 (B)
unnamed: J109.2, JP101.2 (B)
unnamed: D101.3, JP103.2 (B)
VBAT_IN: J101.2; also elsewhere on the board
VBUS: J102.A4 (VBUS), J102.A9 (VBUS), J102.B4 (VBUS), J102.B9 (VBUS); also elsewhere on the board

Notes on the sheet:
ON/OFF 0: OFF 1: ON
OTOS
MOTOR2
PWM
BATTERY
EMERGENGY STOP 0: STOP 1: GO
CAM3
EYE Other MCU
MOTOR3
CAM2
LIDAR
CORD
MOTOR1
CAM1
TEAM

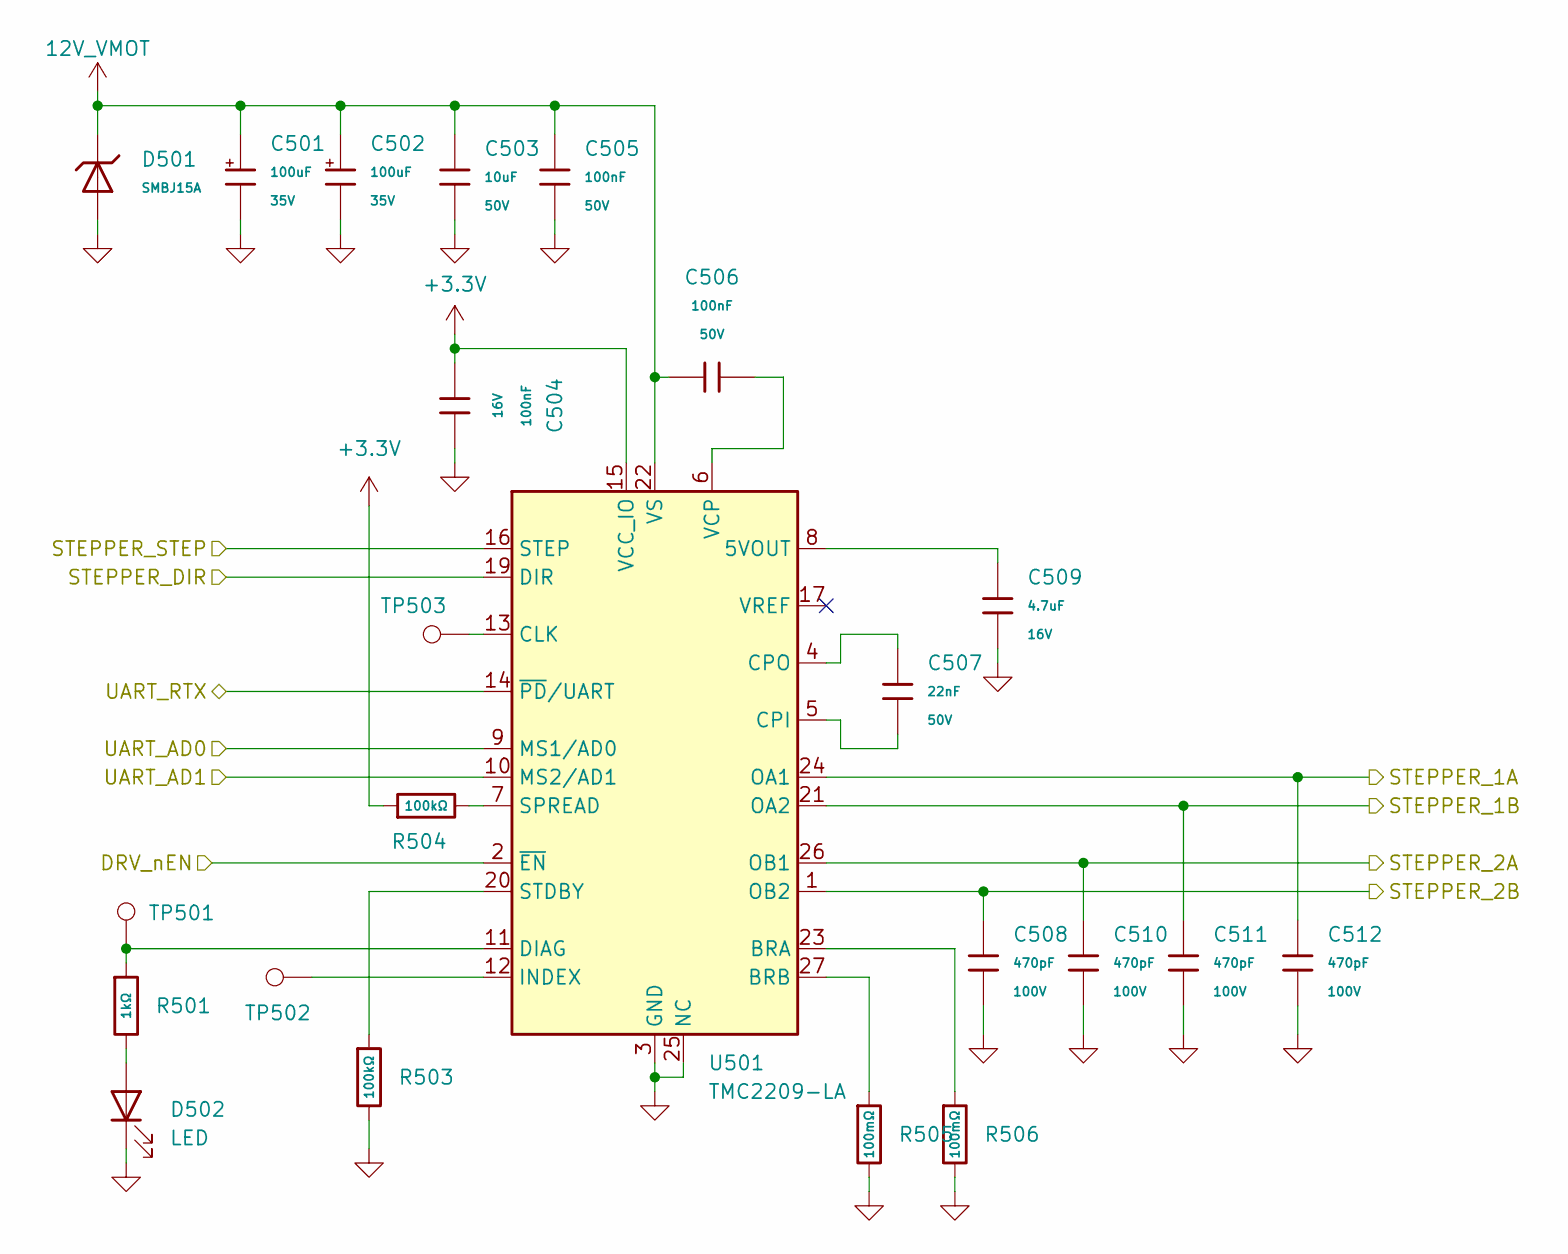
[picture p20: schematic 0200_Motors.kicad_sch, Stepper Motor]

Parts:
C501, C502: 100uF; CP_Elec_6.3x7.7; Tolerance ±10%; Rated Voltage 35V; Part RVT1V101M0607; LCSC C3339
C503: 10uF; C_0805; Voltage Rated 50V; Tolerance ±10%; Part GRM21BR61H106KE43L; LCSC C440198
C504: 100nF; C_0402; Voltage Rated 16V; Tolerance ±10%; Part CL05B104KO5NNNC; LCSC C1525
C505, C506: 100nF; C_0603; Voltage Rated 50V; Tolerance ±10%; Part CC0603KRX7R9BB104; LCSC C14663
C507: 22nF; C_0603; Voltage Rated 50V; Tolerance ±10%; Part CL10B223KB8NNNC; LCSC C21122
C508, C510, C511, C512: 470pF; C_0603; Voltage Rated 100V; Tolerance ±10%; Part 0603B471K101NT; LCSC C43255
C509: 4.7uF; C_0603; Voltage Rated 16V; Tolerance ±10%; Part CL10A475KO8NNNC; LCSC C19666
D501: SMBJ15A; D_SMB; Part SMBJ15A; LCSC C19077569
D502: LED; LED_0603_1608Metric_Pad1.05x0.95mm_HandSolder
R501: 1kΩ; R_0402; Overload Voltage (Max) 50V; Tolerance ±1%; Part 0402WGF1001TCE; LCSC C11702
R503, R504: 100kΩ; R_0402; Overload Voltage (Max) 50V; Tolerance ±1%; Part 0402WGF1003TCE; LCSC C25741
R505, R506: 100mΩ; R_1206; Overload Voltage (Max) 200V; Tolerance ±1%; Part HP06W2F100LT5E; LCSC C414960
TP501, TP502, TP503: TestPoint; TestPoint_Pad_D1.0mm
U501: TMC2209-LA; VQFN-28-1EP_5x5mm_P0.5mm_EP3.7x3.7mm_ThermalVias

Connections:
12V_VMOT: C501.1, C502.1, C503.1, C505.1, C506.1, D501.1, U501.22 (VS), U501.28 (VS); also elsewhere on the board
+3.3V: C504.1, R504.1, U501.15 (VCC_IO); also elsewhere on the board
/MCU/M1_DIR: U501.19 (DIR); also elsewhere on the board
/MCU/M1_STEP: U501.16 (STEP); also elsewhere on the board
/Motor1/DRV_nEN: U501.2 (~EN); also elsewhere on the board
/Motor1/STEPPER_1A: C512.1, U501.24 (OA1); also elsewhere on the board
/Motor1/STEPPER_1B: C511.1, U501.21 (OA2); also elsewhere on the board
/Motor1/STEPPER_2A: C510.1, U501.26 (OB1); also elsewhere on the board
/Motor1/STEPPER_2B: C508.1, U501.1 (OB2); also elsewhere on the board
/Motor1/UART_AD0: U501.9 (MS1/AD0); also elsewhere on the board
/Motor1/UART_AD1: U501.10 (MS2/AD1); also elsewhere on the board
/Motor1/UART_RTX: U501.14 (~PD/UART); also elsewhere on the board
GND: C501.2, C502.2, C503.2, C504.2, C505.2, C508.2, C509.2, C510.2, C511.2, C512.2, D501.2, D502.1 (K), R503.2, R505.2, R506.2, U501.3 (GND), U501.18 (GND), U501.25 (NC), U501.29 (GND); also elsewhere on the board
unnamed: D502.2 (A), R501.2
unnamed: C509.1, U501.8 (5VOUT)
unnamed: R506.1, U501.23 (BRA)
unnamed: R505.1, U501.27 (BRB)
unnamed: TP503.1 (1_1), U501.13 (CLK)
unnamed: C507.2, U501.5 (CPI)
unnamed: C507.1, U501.4 (CPO)
unnamed: R501.1, TP501.1 (1_1), U501.11 (DIAG)
unnamed: TP502.1 (1_1), U501.12 (INDEX)
unnamed: R504.2, U501.7 (SPREAD)
unnamed: R503.1, U501.20 (STDBY)
unnamed: C506.2, U501.6 (VCP)

Parts of its further copies:
C601, C602, C701, C702: 100uF; CP_Elec_6.3x7.7; Tolerance ±10%; Rated Voltage 35V; Part RVT1V101M0607; LCSC C3339
C603, C703: 10uF; C_0805; Voltage Rated 50V; Tolerance ±10%; Part GRM21BR61H106KE43L; LCSC C440198
C604, C704: 100nF; C_0402; Voltage Rated 16V; Tolerance ±10%; Part CL05B104KO5NNNC; LCSC C1525
C605, C606, C705, C706: 100nF; C_0603; Voltage Rated 50V; Tolerance ±10%; Part CC0603KRX7R9BB104; LCSC C14663
C607, C707: 22nF; C_0603; Voltage Rated 50V; Tolerance ±10%; Part CL10B223KB8NNNC; LCSC C21122
C608, C610, C611, C612, C708, C710, C711, C712: 470pF; C_0603; Voltage Rated 100V; Tolerance ±10%; Part 0603B471K101NT; LCSC C43255
C609, C709: 4.7uF; C_0603; Voltage Rated 16V; Tolerance ±10%; Part CL10A475KO8NNNC; LCSC C19666
D601, D701: SMBJ15A; D_SMB; Part SMBJ15A; LCSC C19077569
D602, D702: LED; LED_0603_1608Metric_Pad1.05x0.95mm_HandSolder
R601, R701: 1kΩ; R_0402; Overload Voltage (Max) 50V; Tolerance ±1%; Part 0402WGF1001TCE; LCSC C11702
R603, R604, R703, R704: 100kΩ; R_0402; Overload Voltage (Max) 50V; Tolerance ±1%; Part 0402WGF1003TCE; LCSC C25741
R605, R606, R705, R706: 100mΩ; R_1206; Overload Voltage (Max) 200V; Tolerance ±1%; Part HP06W2F100LT5E; LCSC C414960
TP601, TP602, TP603, TP701, TP702, TP703: TestPoint; TestPoint_Pad_D1.0mm
U601, U701: TMC2209-LA; VQFN-28-1EP_5x5mm_P0.5mm_EP3.7x3.7mm_ThermalVias

Connections of its further copies:
12V_VMOT: C601.1, C602.1, C603.1, C605.1, C606.1, C701.1, C702.1, C703.1, C705.1, C706.1, D601.1, D701.1, U601.22 (VS), U601.28 (VS), U701.22 (VS), U701.28 (VS); also elsewhere on the board
+3.3V: C604.1, C704.1, R604.1, R704.1, U601.15 (VCC_IO), U701.15 (VCC_IO); also elsewhere on the board
/MCU/M2_DIR: U601.19 (DIR); also elsewhere on the board
/MCU/M2_STEP: U601.16 (STEP); also elsewhere on the board
/MCU/M3_DIR: U701.19 (DIR); also elsewhere on the board
/MCU/M3_STEP: U701.16 (STEP); also elsewhere on the board
/Motor1/DRV_nEN: U601.2 (~EN), U701.2 (~EN); also elsewhere on the board
/Motor1/UART_RTX: U601.14 (~PD/UART), U701.14 (~PD/UART); also elsewhere on the board
/Motor2/STEPPER_1A: C612.1, U601.24 (OA1); also elsewhere on the board
/Motor2/STEPPER_1B: C611.1, U601.21 (OA2); also elsewhere on the board
/Motor2/STEPPER_2A: C610.1, U601.26 (OB1); also elsewhere on the board
/Motor2/STEPPER_2B: C608.1, U601.1 (OB2); also elsewhere on the board
/Motor2/UART_AD0: U601.9 (MS1/AD0); also elsewhere on the board
/Motor2/UART_AD1: U601.10 (MS2/AD1); also elsewhere on the board
/Motor3/STEPPER_1A: C712.1, U701.24 (OA1); also elsewhere on the board
/Motor3/STEPPER_1B: C711.1, U701.21 (OA2); also elsewhere on the board
/Motor3/STEPPER_2A: C710.1, U701.26 (OB1); also elsewhere on the board
/Motor3/STEPPER_2B: C708.1, U701.1 (OB2); also elsewhere on the board
/Motor3/UART_AD0: U701.9 (MS1/AD0); also elsewhere on the board
/Motor3/UART_AD1: U701.10 (MS2/AD1); also elsewhere on the board
GND: C601.2, C602.2, C603.2, C604.2, C605.2, C608.2, C609.2, C610.2, C611.2, C612.2, C701.2, C702.2, C703.2, C704.2, C705.2, C708.2, C709.2, C710.2, C711.2, C712.2, D601.2, D602.1 (K), D701.2, D702.1 (K), R603.2, R605.2, R606.2, R703.2, R705.2, R706.2, U601.3 (GND), U601.18 (GND), U601.25 (NC), U601.29 (GND), U701.3 (GND), U701.18 (GND), U701.25 (NC), U701.29 (GND); also elsewhere on the board
unnamed: D602.2 (A), R601.2
unnamed: D702.2 (A), R701.2
unnamed: C609.1, U601.8 (5VOUT)
unnamed: R606.1, U601.23 (BRA)
unnamed: R605.1, U601.27 (BRB)
unnamed: TP603.1 (1_1), U601.13 (CLK)
unnamed: C607.2, U601.5 (CPI)
unnamed: C607.1, U601.4 (CPO)
unnamed: R601.1, TP601.1 (1_1), U601.11 (DIAG)
unnamed: TP602.1 (1_1), U601.12 (INDEX)
unnamed: R604.2, U601.7 (SPREAD)
unnamed: R603.1, U601.20 (STDBY)
unnamed: C606.2, U601.6 (VCP)
unnamed: C709.1, U701.8 (5VOUT)
unnamed: R706.1, U701.23 (BRA)
unnamed: R705.1, U701.27 (BRB)
unnamed: TP703.1 (1_1), U701.13 (CLK)
unnamed: C707.2, U701.5 (CPI)
unnamed: C707.1, U701.4 (CPO)
unnamed: R701.1, TP701.1 (1_1), U701.11 (DIAG)
unnamed: TP702.1 (1_1), U701.12 (INDEX)
unnamed: R704.2, U701.7 (SPREAD)
unnamed: R703.1, U701.20 (STDBY)
unnamed: C706.2, U701.6 (VCP)

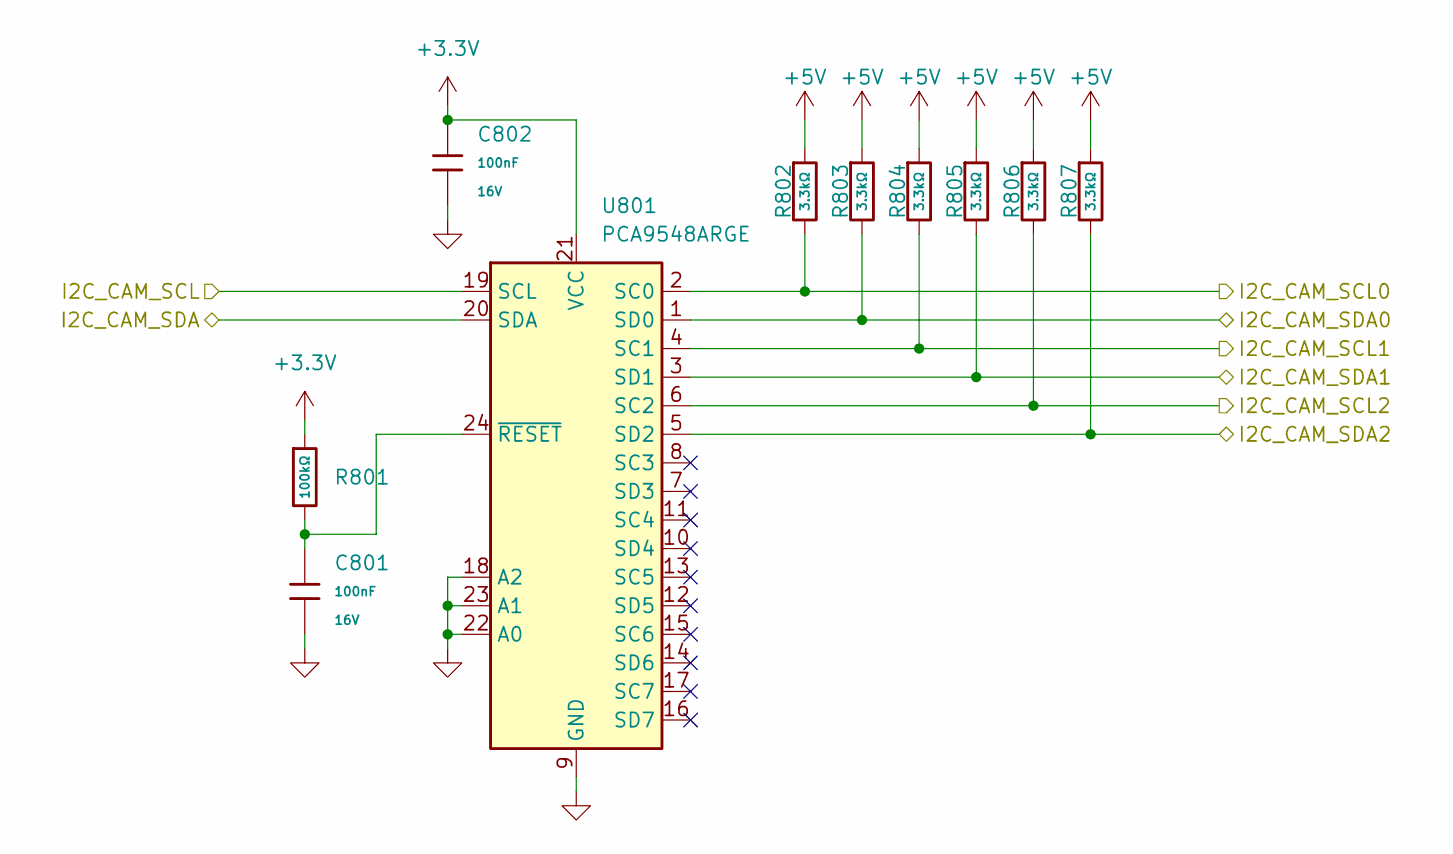
[picture p21: schematic 0300_I2C_CAM.kicad_sch]

Parts:
C801, C802: 100nF; C_0402; Voltage Rated 16V; Tolerance ±10%; Part CL05B104KO5NNNC; LCSC C1525
R801: 100kΩ; R_0402; Overload Voltage (Max) 50V; Tolerance ±1%; Part 0402WGF1003TCE; LCSC C25741
R802, R803, R804, R805, R806, R807: 3.3kΩ; R_0402; Overload Voltage (Max) 50V; Tolerance ±1%; Part 0402WGF3301TCE; LCSC C25890
U801: PCA9548ARGE; Texas_RGE0024C_VQFN-24-1EP_4x4mm_P0.5mm_EP2.1x2.1mm

Connections:
+3.3V: C802.2, R801.1, U801.21 (VCC); also elsewhere on the board
+5V: R802.1, R803.1, R804.1, R805.1, R806.1, R807.1; also elsewhere on the board
/I2C_CAM/I2C_CAM_SCL0: R802.2, U801.2 (SC0); also elsewhere on the board
/I2C_CAM/I2C_CAM_SCL1: R804.2, U801.4 (SC1); also elsewhere on the board
/I2C_CAM/I2C_CAM_SCL2: R806.2, U801.6 (SC2); also elsewhere on the board
/I2C_CAM/I2C_CAM_SDA0: R803.2, U801.1 (SD0); also elsewhere on the board
/I2C_CAM/I2C_CAM_SDA1: R805.2, U801.3 (SD1); also elsewhere on the board
/I2C_CAM/I2C_CAM_SDA2: R807.2, U801.5 (SD2); also elsewhere on the board
/MCU/I2C_CAM_SCL: U801.19 (SCL); also elsewhere on the board
/MCU/I2C_CAM_SDA: U801.20 (SDA); also elsewhere on the board
GND: C801.1, C802.1, U801.9 (GND), U801.18 (A2), U801.22 (A0), U801.23 (A1); also elsewhere on the board
unnamed: C801.2, R801.2, U801.24 (~RESET)

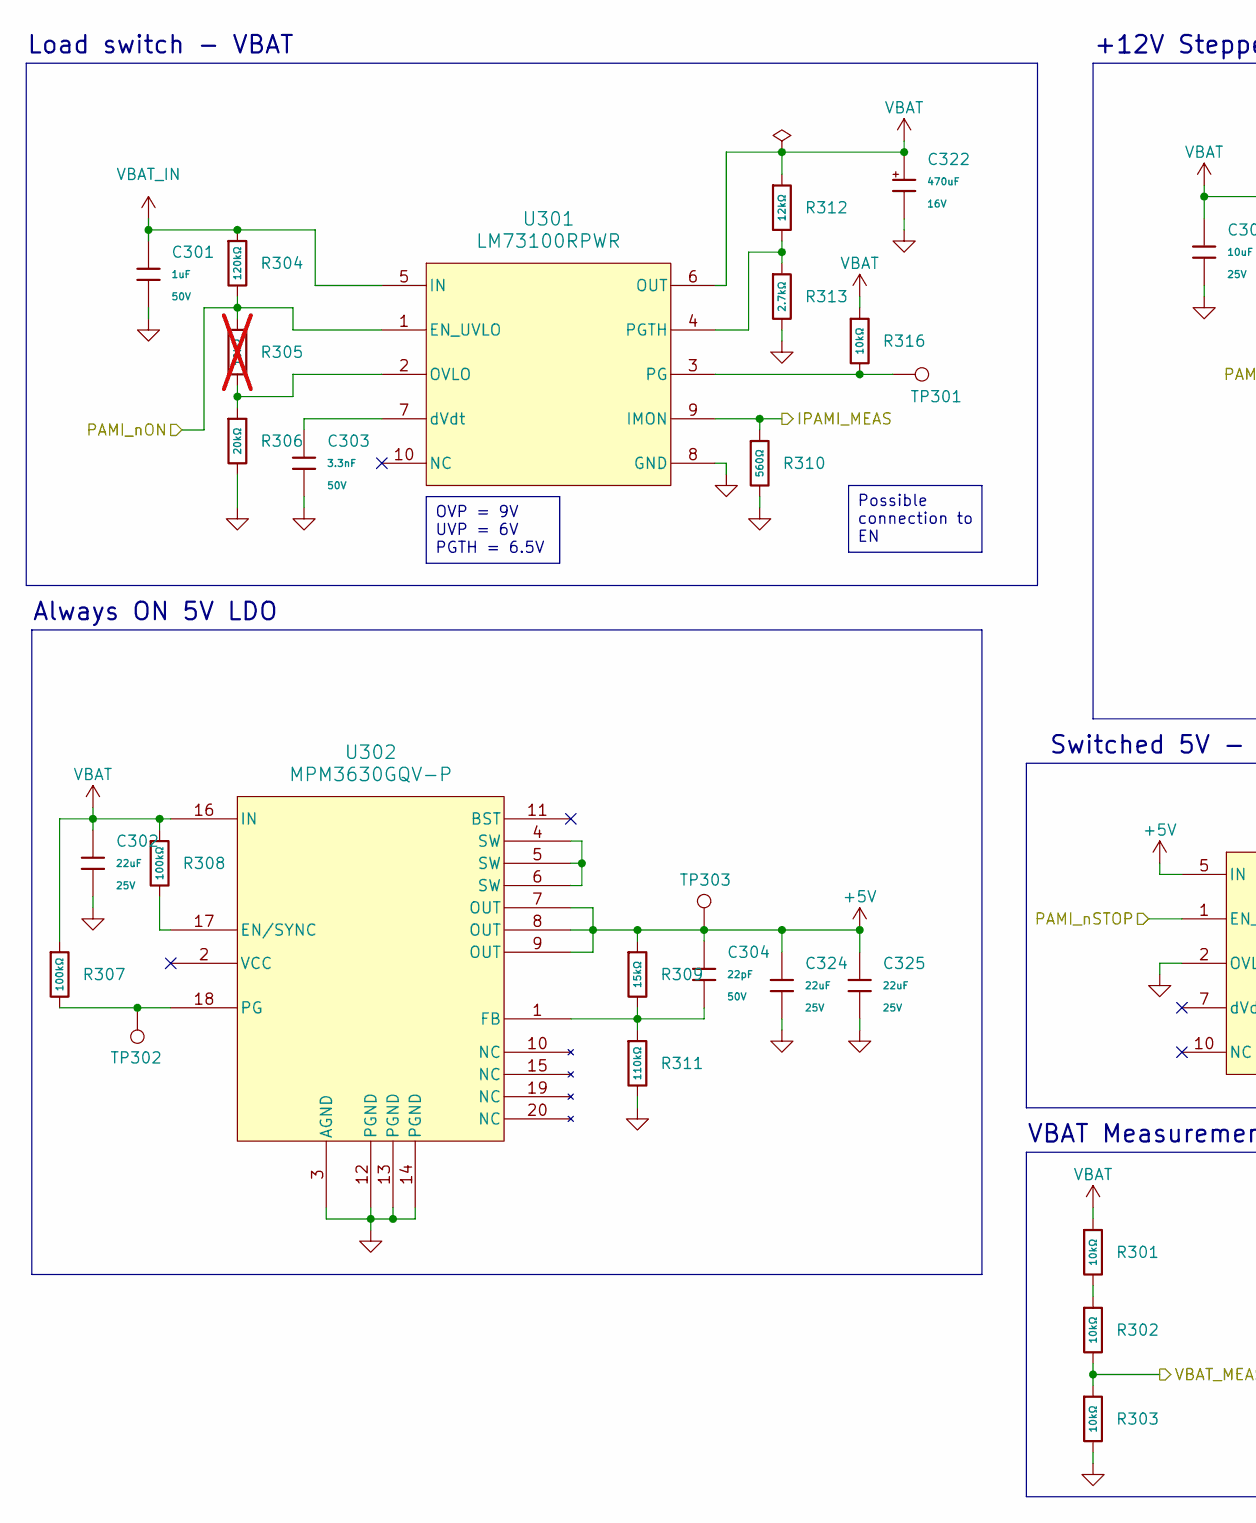
[picture p22: schematic 0500_Power.kicad_sch, Power, part in row 1, column 1]

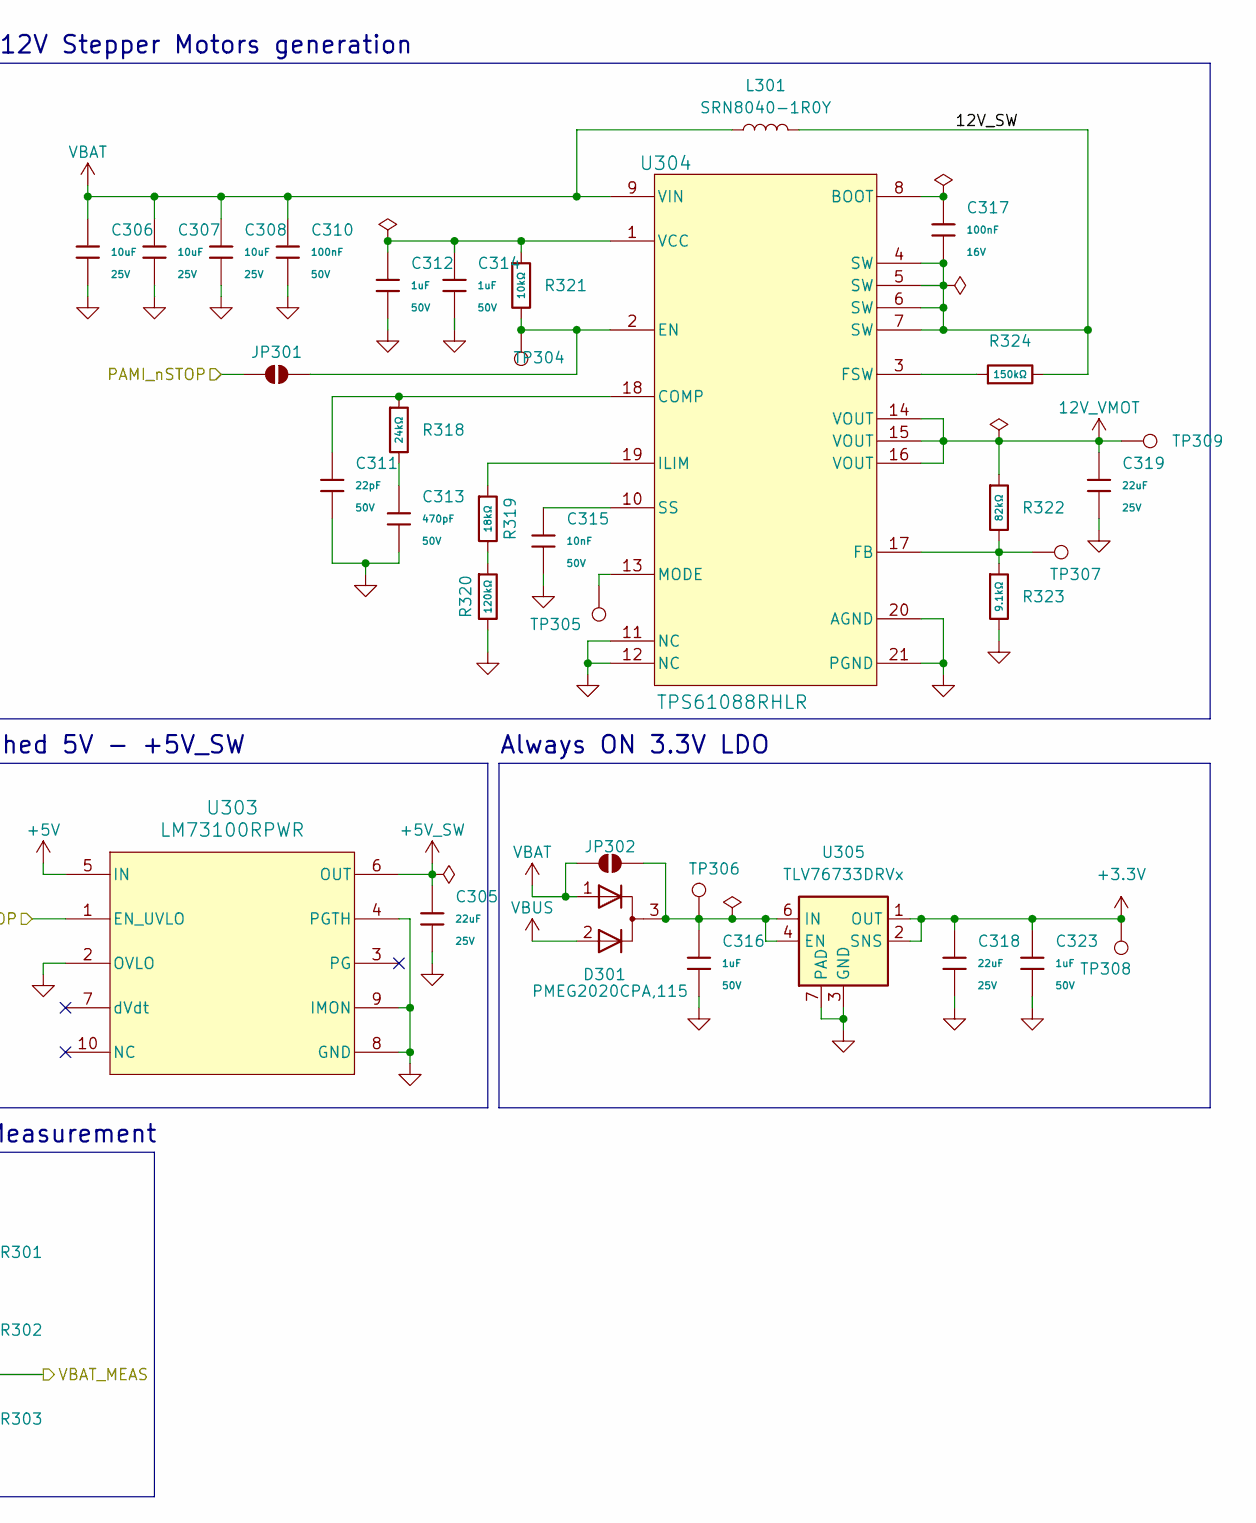
[picture p23: schematic 0500_Power.kicad_sch, Power, part in row 1, column 2]

Parts:
C301, C312, C314, C316, C323: 1uF; C_0603; Voltage Rated 50V; Tolerance ±10%; Part CL10A105KB8NNNC; LCSC C15849
C302, C305, C318, C319, C324, C325: 22uF; C_0805; Voltage Rated 25V; Tolerance ±20%; Part CL21A226MAQNNNE; LCSC C45783
C303: 3.3nF; C_0402; Voltage Rated 50V; Tolerance ±10%; Part CL05B332KB5NNNC; LCSC C26404
C304, C311: 22pF; C_0402; Voltage Rated 50V; Tolerance ±5%; Part 0402CG220J500NT; LCSC C1555
C306, C307, C308: 10uF; C_0805; Voltage Rated 25V; Tolerance ±10%; Part CL21A106KAYNNNE; LCSC C15850
C310: 100nF; C_0603; Voltage Rated 50V; Tolerance ±10%; Part CC0603KRX7R9BB104; LCSC C14663
C313: 470pF; C_0402; Voltage Rated 50V; Tolerance ±10%; Part 0402B471K500NT; LCSC C1537
C315: 10nF; C_0402; Voltage Rated 50V; Tolerance ±10%; Part CL05B103KB5NNNC; LCSC C15195
C317: 100nF; C_0402; Voltage Rated 16V; Tolerance ±10%; Part CL05B104KO5NNNC; LCSC C1525
C322: 470uF; CP_Elec_8x10; Tolerance ±10%; Rated Voltage 16V; Part RVT1C471M0810; LCSC C3341
D301: PMEG2020CPA,115; HUSON-3-1EP_2x2mm_P1.3mm_EP1.1x1.6mm
JP301, JP302: SolderJumper_2_Open; SolderJumper-2_P1.3mm_Open_RoundedPad1.0x1.5mm
L301: SRN8040-1R0Y; L_Bourns-SRN8040_8x8.15mm
R301, R302, R303, R316, R321: 10kΩ; R_0402; Overload Voltage (Max) 50V; Tolerance ±1%; Part 0402WGF1002TCE; LCSC C25744
R304, R320: 120kΩ; R_0402; Overload Voltage (Max) 50V; Tolerance ±1%; Part 0402WGF1203TCE; LCSC C25750
R305: 10kΩ; R_0402; Overload Voltage (Max) 50V; Tolerance ±1%; Part 0402WGF1002TCE; LCSC C25744; not fitted
R306: 20kΩ; R_0402; Overload Voltage (Max) 50V; Tolerance ±1%; Part 0402WGF2002TCE; LCSC C25765
R307, R308: 100kΩ; R_0402; Overload Voltage (Max) 50V; Tolerance ±1%; Part 0402WGF1003TCE; LCSC C25741
R309: 15kΩ; R_0402; Overload Voltage (Max) 50V; Tolerance ±1%; Part 0402WGF1502TCE; LCSC C25756
R310: 560Ω; R_0603; Overload Voltage (Max) 75V; Tolerance ±1%; Part 0603WAF5600T5E; LCSC C23204
R311: 110kΩ; R_0402; Overload Voltage (Max) 50V; Tolerance ±1%; Part 0402WGF1103TCE; LCSC C25745
R312: 12kΩ; R_0402; Overload Voltage (Max) 50V; Tolerance ±1%; Part 0402WGF1202TCE; LCSC C25752
R313: 2.7kΩ; R_0603; Overload Voltage (Max) 75V; Tolerance ±1%; Part 0603WAF2701T5E; LCSC C13167
R318: 24kΩ; R_0402; Overload Voltage (Max) 50V; Tolerance ±1%; Part 0402WGF2402TCE; LCSC C25769
R319: 18kΩ; R_0402; Overload Voltage (Max) 50V; Tolerance ±1%; Part 0402WGF1802TCE; LCSC C25762
R322: 82kΩ; R_0603; Overload Voltage (Max) 75V; Tolerance ±1%; Part 0603WAF8202T5E; LCSC C23254
R323: 9.1kΩ; R_0603; Overload Voltage (Max) 75V; Tolerance ±1%; Part 0603WAF9101T5E; LCSC C23260
R324: 150kΩ; R_0402; Overload Voltage (Max) 50V; Tolerance ±1%; Part 0402WGF1503TCE; LCSC C25755
TP301, TP302, TP303, TP304, TP305, TP306, TP307, TP308, TP309: TestPoint; TestPoint_Pad_D1.0mm
U301, U303: LM73100RPWR; RPW0010A-MFG
U302: MPM3630GQV-P; MPM3630_MNP
U304: TPS61088RHLR; RHL0020A
U305: TLV76733DRVx; WSON-6-1EP_2x2mm_P0.65mm_EP1x1.6mm_ThermalVias

Connections:
12V_VMOT: C319.1, R322.1, TP309.1 (1_1), U304.14 (VOUT), U304.15 (VOUT), U304.16 (VOUT); also elsewhere on the board
+3.3V: C318.1, C323.1, TP308.1 (1_1), U305.1 (OUT), U305.2 (SNS); also elsewhere on the board
+5V: C304.1, C324.1, C325.1, R309.1, TP303.1 (1_1), U302.7 (OUT), U302.8 (OUT), U302.9 (OUT), U303.5 (IN); also elsewhere on the board
+5V_SW: C305.1, U303.6 (OUT); also elsewhere on the board
/MCU/IPAMI_MEAS: R310.1, U301.9 (IMON); also elsewhere on the board
/MCU/VBAT_MEAS: R302.2, R303.1; also elsewhere on the board
/PAMI_nON: R304.2, R305.1, U301.1 (EN_UVLO); also elsewhere on the board
/PAMI_nSTOP: JP301.1 (A), U303.1 (EN_UVLO); also elsewhere on the board
/Power/12V_SW: C317.1, L301.2, R324.2, U304.4 (SW), U304.5 (SW), U304.6 (SW), U304.7 (SW)
GND: C301.2, C302.2, C303.2, C305.2, C306.2, C307.2, C308.2, C310.2, C311.2, C312.2, C313.2, C314.2, C315.2, C316.2, C318.2, C319.2, C322.2, C323.2, C324.2, C325.2, R303.2, R306.2, R310.2, R311.2, R313.2, R320.2, R323.2, U301.8 (GND), U302.3 (AGND), U302.12 (PGND), U302.13 (PGND), U302.14 (PGND), U303.2 (OVLO), U303.4 (PGTH), U303.8 (GND), U303.9 (IMON), U304.11 (NC), U304.12 (NC), U304.20 (AGND), U304.21 (PGND), U305.3 (GND), U305.5 (GND), U305.7 (PAD); also elsewhere on the board
unnamed: C313.1, R318.2
unnamed: C316.1, D301.3 (K), JP302.2 (B), TP306.1 (1_1), U305.4 (EN), U305.6 (IN)
unnamed: JP301.2 (B), R321.2, TP304.1 (1_1), U304.2 (EN)
unnamed: R301.2, R302.1
unnamed: R319.2, R320.1
unnamed: R305.2, R306.1, U301.2 (OVLO)
unnamed: R316.2, TP301.1 (1_1), U301.3 (PG)
unnamed: R312.2, R313.1, U301.4 (PGTH)
unnamed: C303.1, U301.7 (dVdt)
unnamed: R308.2, U302.17 (EN/SYNC)
unnamed: C304.2, R309.2, R311.1, U302.1 (FB)
unnamed: R307.2, TP302.1 (1_1), U302.18 (PG)
unnamed: U302.4 (SW), U302.5 (SW), U302.6 (SW)
unnamed: C317.2, U304.8 (BOOT)
unnamed: C311.1, R318.1, U304.18 (COMP)
unnamed: R322.2, R323.1, TP307.1 (1_1), U304.17 (FB)
unnamed: R324.1, U304.3 (FSW)
unnamed: R319.1, U304.19 (ILIM)
unnamed: TP305.1 (1_1), U304.13 (MODE)
unnamed: C315.1, U304.10 (SS)
unnamed: C312.1, C314.1, R321.1, U304.1 (VCC)
VBAT: C302.1, C306.1, C307.1, C308.1, C310.1, C322.1, D301.1 (A), JP302.1 (A), L301.1, R301.1, R307.1, R308.1, R312.1, R316.1, U301.6 (OUT), U302.16 (IN), U304.9 (VIN); also elsewhere on the board
VBAT_IN: C301.1, R304.1, U301.5 (IN); also elsewhere on the board
VBUS: D301.2 (A); also elsewhere on the board

Notes on the sheet:
Always ON 5V LDO
VBAT Measurement
Load switch - VBAT
Always ON 3.3V LDO
+12V Stepper Motors generation
Switched 5V - +5V_SW
OVP = 9V UVP = 6V PGTH = 6.5V
Possible connection to EN
