Les-opossums/ELE_PAMI_2027/PAMI_2027_A1.kicad_pcb

## KiCad design PAMI_2027_A1.kicad_pcb (continued)

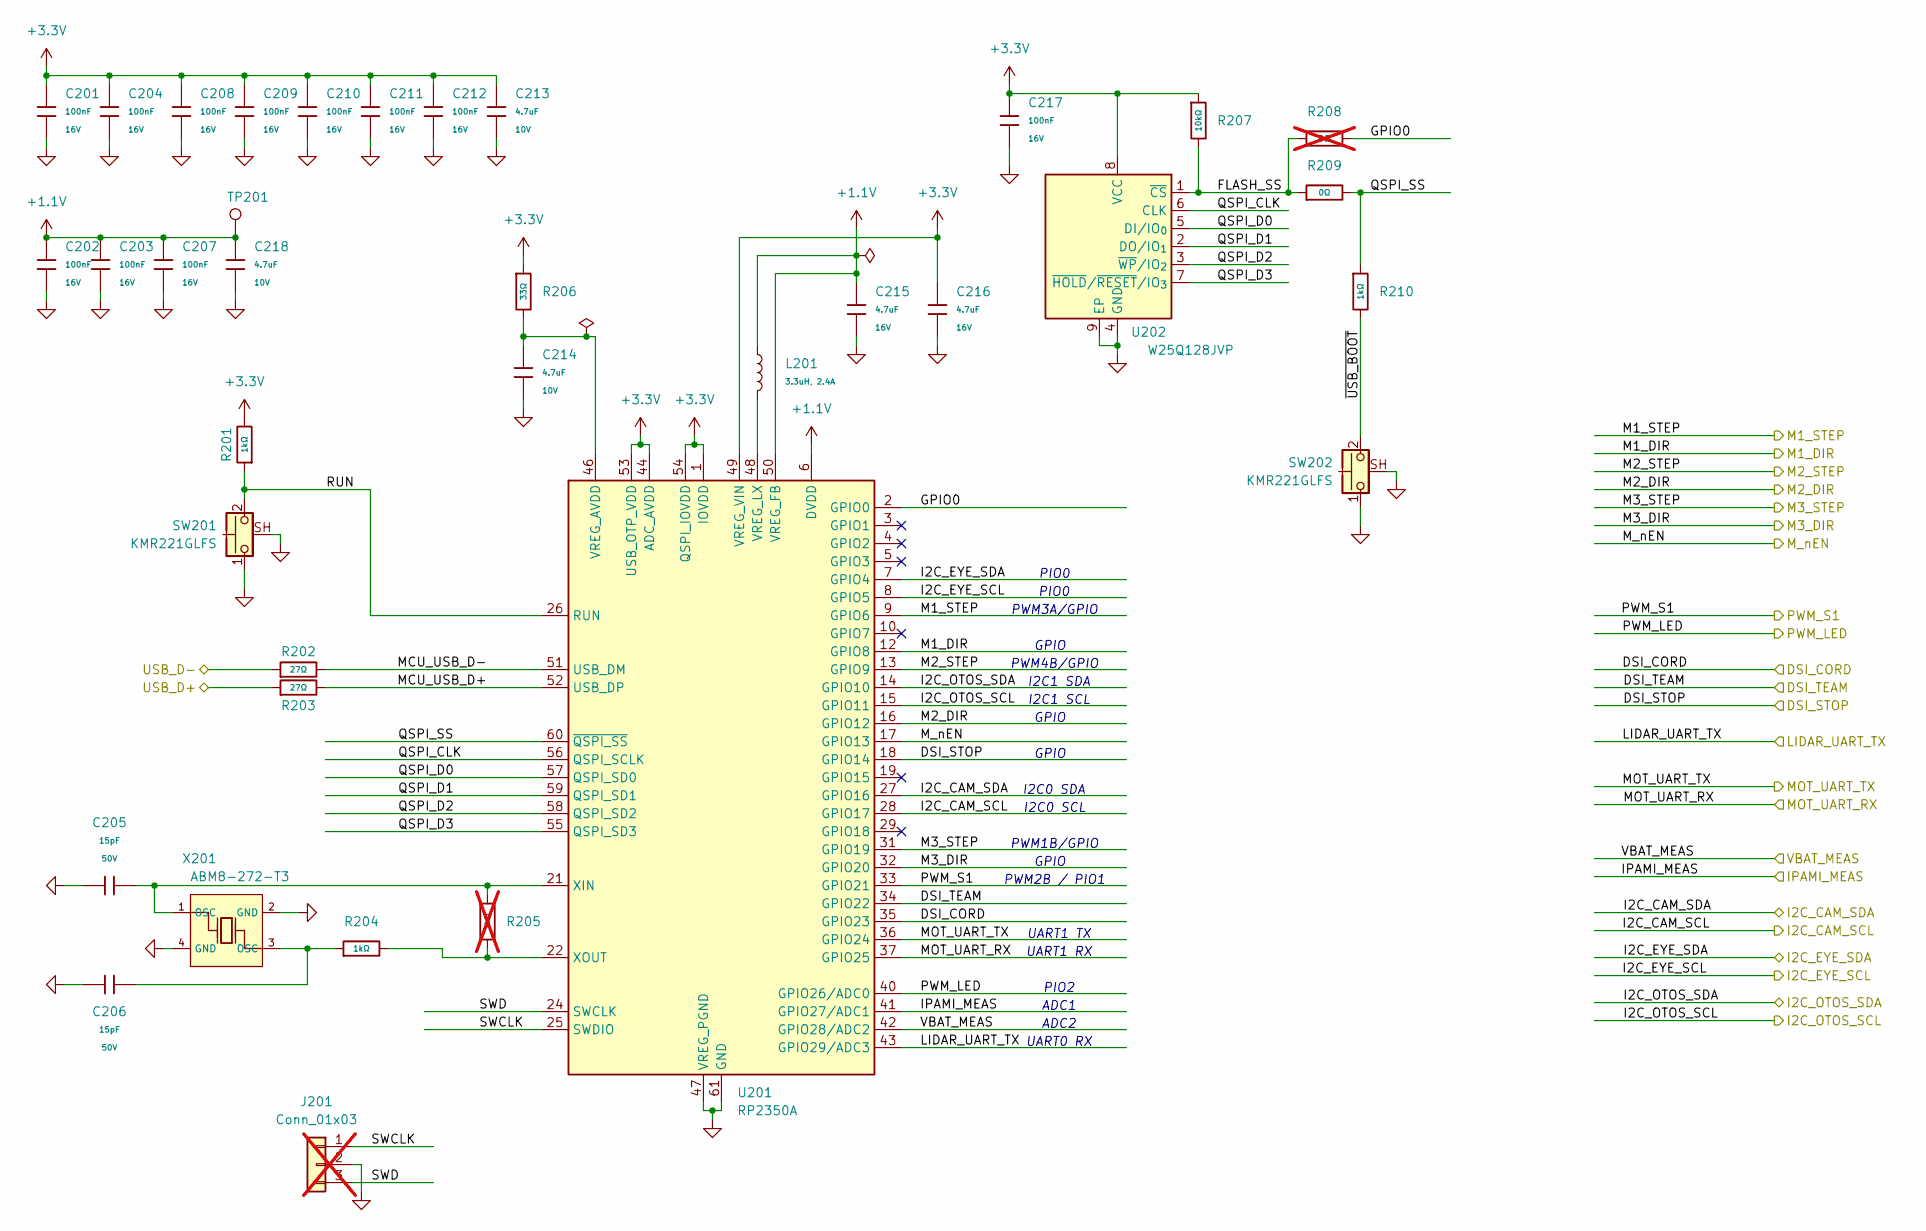
[picture p24: schematic 0100_MCU.kicad_sch, Microcontroller - RP2350]

Parts:
C201, C202, C203, C204, C207, C208, C209, C210, C211, C212, C217: 100nF; C_0402; Voltage Rated 16V; Tolerance ±10%; Part CL05B104KO5NNNC; LCSC C1525
C205, C206: 15pF; C_0402; Voltage Rated 50V; Tolerance ±5%; Part 0402CG150J500NT; LCSC C1548
C213, C214, C218: 4.7uF; C_0402; Voltage Rated 10V; Tolerance ±20%; Part CL05A475MP5NRNC; LCSC C23733
C215, C216: 4.7uF; C_0603; Voltage Rated 16V; Tolerance ±10%; Part CL10A475KO8NNNC; LCSC C19666
J201: Conn_01x03; PinHeader_1x03_P2.54mm_Vertical; not fitted
L201: 3.3uH, 2.4A; L_Changjiang_FTC201612S; Part FTC201612S3R3MBCD; LCSC C53281610
R201, R204, R210: 1kΩ; R_0402; Overload Voltage (Max) 50V; Tolerance ±1%; Part 0402WGF1001TCE; LCSC C11702
R202, R203: 27Ω; R_0402; Overload Voltage (Max) 50V; Tolerance ±1%; Part 0402WGF270JTCE; LCSC C25100
R205: 1kΩ; R_0603; Overload Voltage (Max) 75V; Tolerance ±1%; Part 0603WAF1001T5E; LCSC C21190; not fitted
R206: 33Ω; R_0402; Overload Voltage (Max) 50V; Tolerance ±1%; Part 0402WGF330JTCE; LCSC C25105
R207: 10kΩ; R_0402; Overload Voltage (Max) 50V; Tolerance ±1%; Part 0402WGF1002TCE; LCSC C25744
R208: 0Ω; R_0402; Overload Voltage (Max) 50V; Tolerance ±1%; Part 0402WGF0000TCE; LCSC C17168; not fitted
R209: 0Ω; R_0402; Overload Voltage (Max) 50V; Tolerance ±1%; Part 0402WGF0000TCE; LCSC C17168
SW201, SW202: KMR221GLFS; SW_Push_1P1T-SH_NO_CK_KMR2xxG
TP201: TestPoint; TestPoint_Pad_D1.0mm
U201: RP2350A; QFN-60-1EP_7x7mm_P0.4mm_EP3.4x3.4mm
U202: W25Q128JVP; WSON-8-1EP_6x5mm_P1.27mm_EP3.4x4.3mm
X201: ABM8-272-T3; Crystal_SMD_Abracon_ABM8G-4Pin_3.2x2.5mm; Frequency Tolerance ±10ppm; Part X322512MMB4SI; LCSC C20625731

Connections:
+1.1V: C202.1, C203.1, C207.1, C215.1, C218.1, L201.1, TP201.1 (1_1), U201.6 (DVDD), U201.23 (DVDD), U201.39 (DVDD), U201.50 (VREG_FB)
+3.3V: C201.1, C204.1, C208.1, C209.1, C210.1, C211.1, C212.1, C213.1, C216.1, C217.1, R201.2, R206.1, R207.1, U201.1 (IOVDD), U201.11 (IOVDD), U201.20 (IOVDD), U201.30 (IOVDD), U201.38 (IOVDD), U201.44 (ADC_AVDD), U201.45 (IOVDD), U201.49 (VREG_VIN), U201.53 (USB_OTP_VDD), U201.54 (QSPI_IOVDD), U202.8 (VCC); also elsewhere on the board
/I2C_EYE_SCL: U201.8 (GPIO5); also elsewhere on the board
/I2C_EYE_SDA: U201.7 (GPIO4); also elsewhere on the board
/I2C_OTOS_SCL: U201.15 (GPIO11); also elsewhere on the board
/I2C_OTOS_SDA: U201.14 (GPIO10); also elsewhere on the board
/MCU/DSI_CORD: U201.35 (GPIO23); also elsewhere on the board
/MCU/DSI_TEAM: U201.34 (GPIO22); also elsewhere on the board
/MCU/FLASH_SS: R207.2, R208.1, R209.1, U202.1 (~CS)
/MCU/GPIO0: R208.2, U201.2 (GPIO0)
/MCU/I2C_CAM_SCL: U201.28 (GPIO17); also elsewhere on the board
/MCU/I2C_CAM_SDA: U201.27 (GPIO16); also elsewhere on the board
/MCU/IPAMI_MEAS: U201.41 (GPIO27/ADC1); also elsewhere on the board
/MCU/LIDAR_UART_TX: U201.43 (GPIO29/ADC3); also elsewhere on the board
/MCU/M1_DIR: U201.12 (GPIO8); also elsewhere on the board
/MCU/M1_STEP: U201.9 (GPIO6); also elsewhere on the board
/MCU/M2_DIR: U201.16 (GPIO12); also elsewhere on the board
/MCU/M2_STEP: U201.13 (GPIO9); also elsewhere on the board
/MCU/M3_DIR: U201.32 (GPIO20); also elsewhere on the board
/MCU/M3_STEP: U201.31 (GPIO19); also elsewhere on the board
/MCU/MCU_USB_D+: R203.2, U201.52 (USB_DP)
/MCU/MCU_USB_D-: R202.2, U201.51 (USB_DM)
/MCU/MOT_UART_RX: U201.37 (GPIO25); also elsewhere on the board
/MCU/MOT_UART_TX: U201.36 (GPIO24); also elsewhere on the board
/MCU/PWM_LED: U201.40 (GPIO26/ADC0); also elsewhere on the board
/MCU/PWM_S1: U201.33 (GPIO21); also elsewhere on the board
/MCU/QSPI_CLK: U201.56 (QSPI_SCLK), U202.6 (CLK)
/MCU/QSPI_D0: U201.57 (QSPI_SD0), U202.5 (DI/IO_{0})
/MCU/QSPI_D1: U201.59 (QSPI_SD1), U202.2 (DO/IO_{1})
/MCU/QSPI_D2: U201.58 (QSPI_SD2), U202.3 (~WP/IO_{2})
/MCU/QSPI_D3: U201.55 (QSPI_SD3), U202.7 (~HOLD/~RESET/IO_{3})
/MCU/QSPI_SS: R209.2, R210.1, U201.60 (~QSPI_SS)
/MCU/RUN: R201.1, SW201.2, U201.26 (RUN)
/MCU/SWCLK: J201.1, U201.25 (SWDIO)
/MCU/SWD: J201.3, U201.24 (SWCLK)
/MCU/USB_D+: R203.1; also elsewhere on the board
/MCU/USB_D-: R202.1; also elsewhere on the board
/MCU/VBAT_MEAS: U201.42 (GPIO28/ADC2); also elsewhere on the board
/MCU/~USB_BOOT: R210.2, SW202.2
/M_nEN: U201.17 (GPIO13); also elsewhere on the board
/PAMI_STOP: U201.18 (GPIO14); also elsewhere on the board
GND: C201.2, C202.2, C203.2, C204.2, C205.1, C206.1, C207.2, C208.2, C209.2, C210.2, C211.2, C212.2, C213.2, C214.2, C215.2, C216.2, C217.2, C218.2, J201.2, SW201.1, SW201.SH (B), SW202.1, SW202.SH (B), U201.47 (VREG_PGND), U201.61 (GND), U202.4 (GND), U202.9 (EP), X201.2 (GND), X201.4 (GND); also elsewhere on the board
unnamed: C206.2, R204.1, X201.3 (OSC)
unnamed: C214.1, R206.2, U201.46 (VREG_AVDD)
unnamed: L201.2, U201.48 (VREG_LX)
unnamed: C205.2, R205.1, U201.21 (XIN), X201.1 (OSC)
unnamed: R204.2, R205.2, U201.22 (XOUT)

Notes on the sheet:
PIO0
PWM4B/GPIO
UART1 RX
UART1 TX
UART0 RX
I2C1 SDA
I2C0 SDA
PWM3A/GPIO
PIO2
ADC2
GPIO
I2C1 SCL
I2C0 SCL
ADC1
PWM1B/GPIO
PWM2B / PIO1

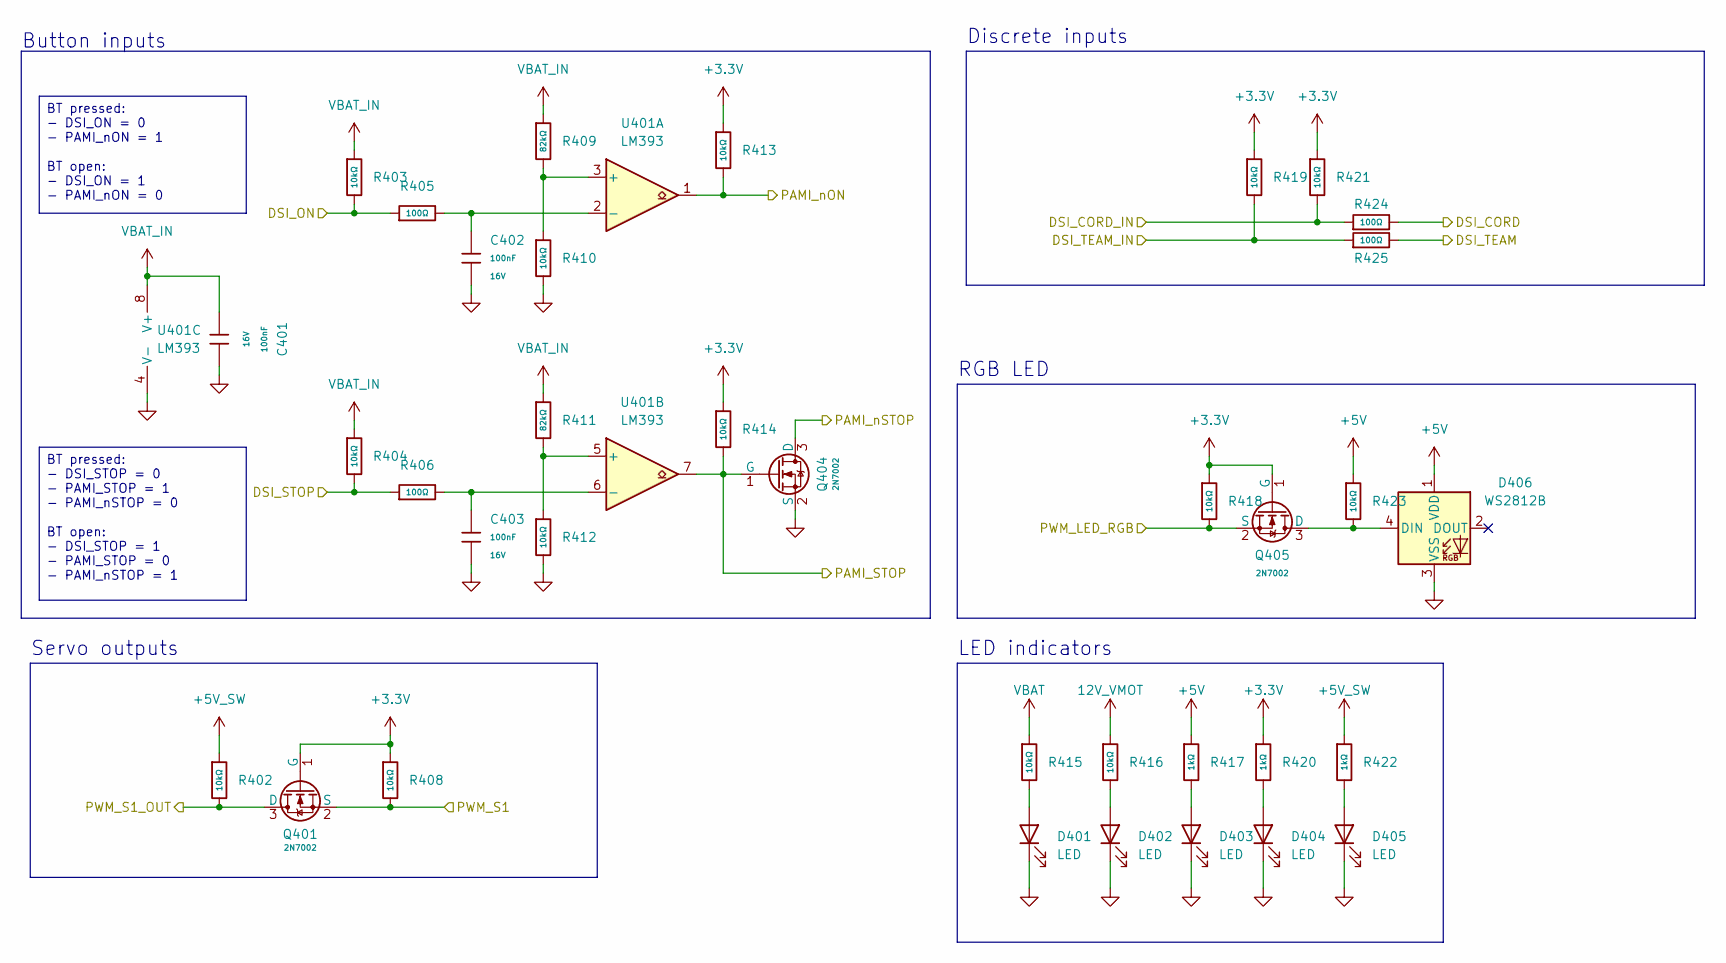
[picture p25: schematic 0400_IOEXT.kicad_sch, IO Adaptation Stage]

Parts:
C401, C402, C403: 100nF; C_0402; Voltage Rated 16V; Tolerance ±10%; Part CL05B104KO5NNNC; LCSC C1525
D401, D402, D403, D404, D405: LED; LED_0603_1608Metric
D406: WS2812B; LED_WS2812B_PLCC4_5.0x5.0mm_P3.2mm
Q401, Q404, Q405: 2N7002; Q_SOT-23; Part 2N7002; LCSC C8545
R402, R403, R404, R408, R410, R412, R413, R414, R415, R416, R418, R419, R421, R423: 10kΩ; R_0402; Overload Voltage (Max) 50V; Tolerance ±1%; Part 0402WGF1002TCE; LCSC C25744
R405, R406, R424, R425: 100Ω; R_0402; Overload Voltage (Max) 50V; Tolerance ±1%; Part 0402WGF1000TCE; LCSC C25076
R409, R411: 82kΩ; R_0603; Overload Voltage (Max) 75V; Tolerance ±1%; Part 0603WAF8202T5E; LCSC C23254
R417, R420, R422: 1kΩ; R_0402; Overload Voltage (Max) 50V; Tolerance ±1%; Part 0402WGF1001TCE; LCSC C11702
U401: LM393; SOIC-8_3.9x4.9mm_P1.27mm

Connections:
12V_VMOT: R416.1; also elsewhere on the board
+3.3V: Q401.1 (G), Q405.1 (G), R408.1, R413.1, R414.1, R418.1, R419.1, R420.1, R421.1; also elsewhere on the board
+5V: D406.1 (VDD), R417.1, R423.1; also elsewhere on the board
+5V_SW: R402.1, R422.1; also elsewhere on the board
/IO/DSI_CORD_IN: R421.2, R424.1; also elsewhere on the board
/IO/DSI_ON: R403.2, R405.1; also elsewhere on the board
/IO/DSI_STOP: R404.2, R406.1; also elsewhere on the board
/IO/DSI_TEAM_IN: R419.2, R425.1; also elsewhere on the board
/IO/PWM_S1_OUT: Q401.3 (D), R402.2; also elsewhere on the board
/MCU/DSI_CORD: R424.2; also elsewhere on the board
/MCU/DSI_TEAM: R425.2; also elsewhere on the board
/MCU/PWM_LED: Q405.2 (S), R418.2; also elsewhere on the board
/MCU/PWM_S1: Q401.2 (S), R408.2; also elsewhere on the board
/PAMI_STOP: Q404.1 (G), R414.2, U401.7; also elsewhere on the board
/PAMI_nON: R413.2, U401.1; also elsewhere on the board
/PAMI_nSTOP: Q404.3 (D); also elsewhere on the board
GND: C401.2, C402.1, C403.1, D401.1 (K), D402.1 (K), D403.1 (K), D404.1 (K), D405.1 (K), D406.3 (VSS), Q404.2 (S), R410.2, R412.2, U401.4 (V-); also elsewhere on the board
unnamed: D401.2 (A), R415.2
unnamed: D402.2 (A), R416.2
unnamed: D403.2 (A), R417.2
unnamed: D404.2 (A), R420.2
unnamed: D405.2 (A), R422.2
unnamed: D406.4 (DIN), Q405.3 (D), R423.2
unnamed: R409.2, R410.1, U401.3 (+)
unnamed: C402.2, R405.2, U401.2 (-)
unnamed: R411.2, R412.1, U401.5 (+)
unnamed: C403.2, R406.2, U401.6 (-)
VBAT: R415.1; also elsewhere on the board
VBAT_IN: C401.1, R403.1, R404.1, R409.1, R411.1, U401.8 (V+); also elsewhere on the board

Notes on the sheet:
LED indicators
Discrete inputs
RGB LED
Button inputs
Servo outputs
BT pressed: - DSI_STOP = 0 - PAMI_STOP = 1 - PAMI_nSTOP = 0 BT open: - DSI_STOP = 1 - PAMI_STOP = 0 - PAMI_nSTOP = 1
BT pressed: - DSI_ON = 0 - PAMI_nON = 1 BT open: - DSI_ON = 1 - PAMI_nON = 0

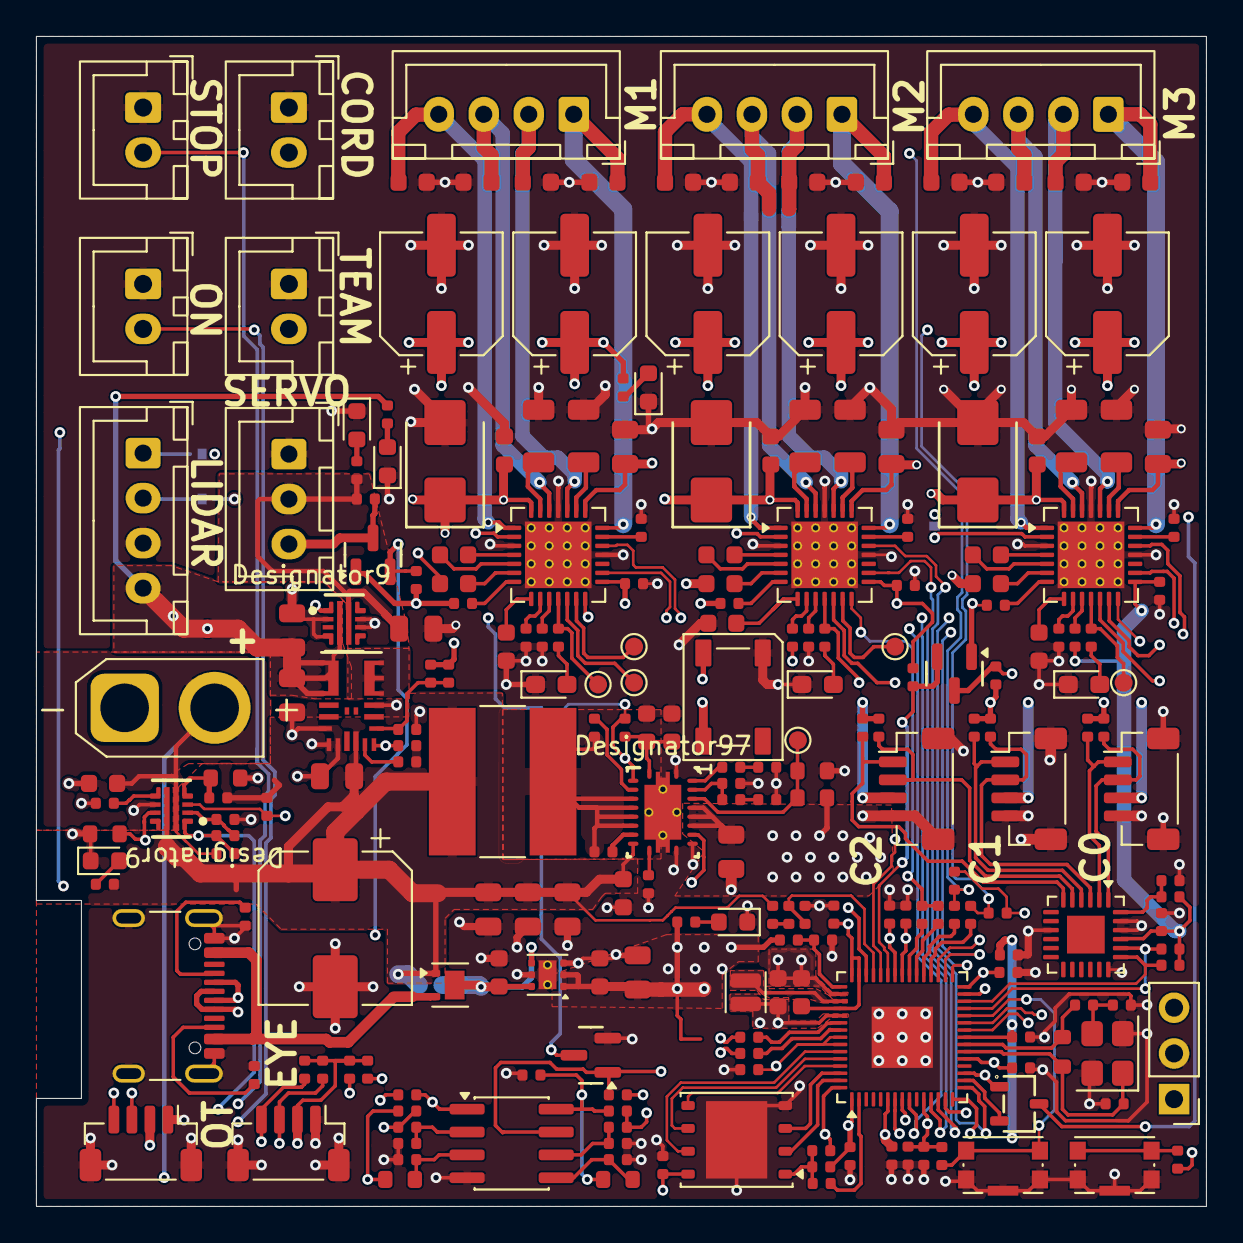
[picture p26: board PAMI_2027_A1.kicad_pcb from above]

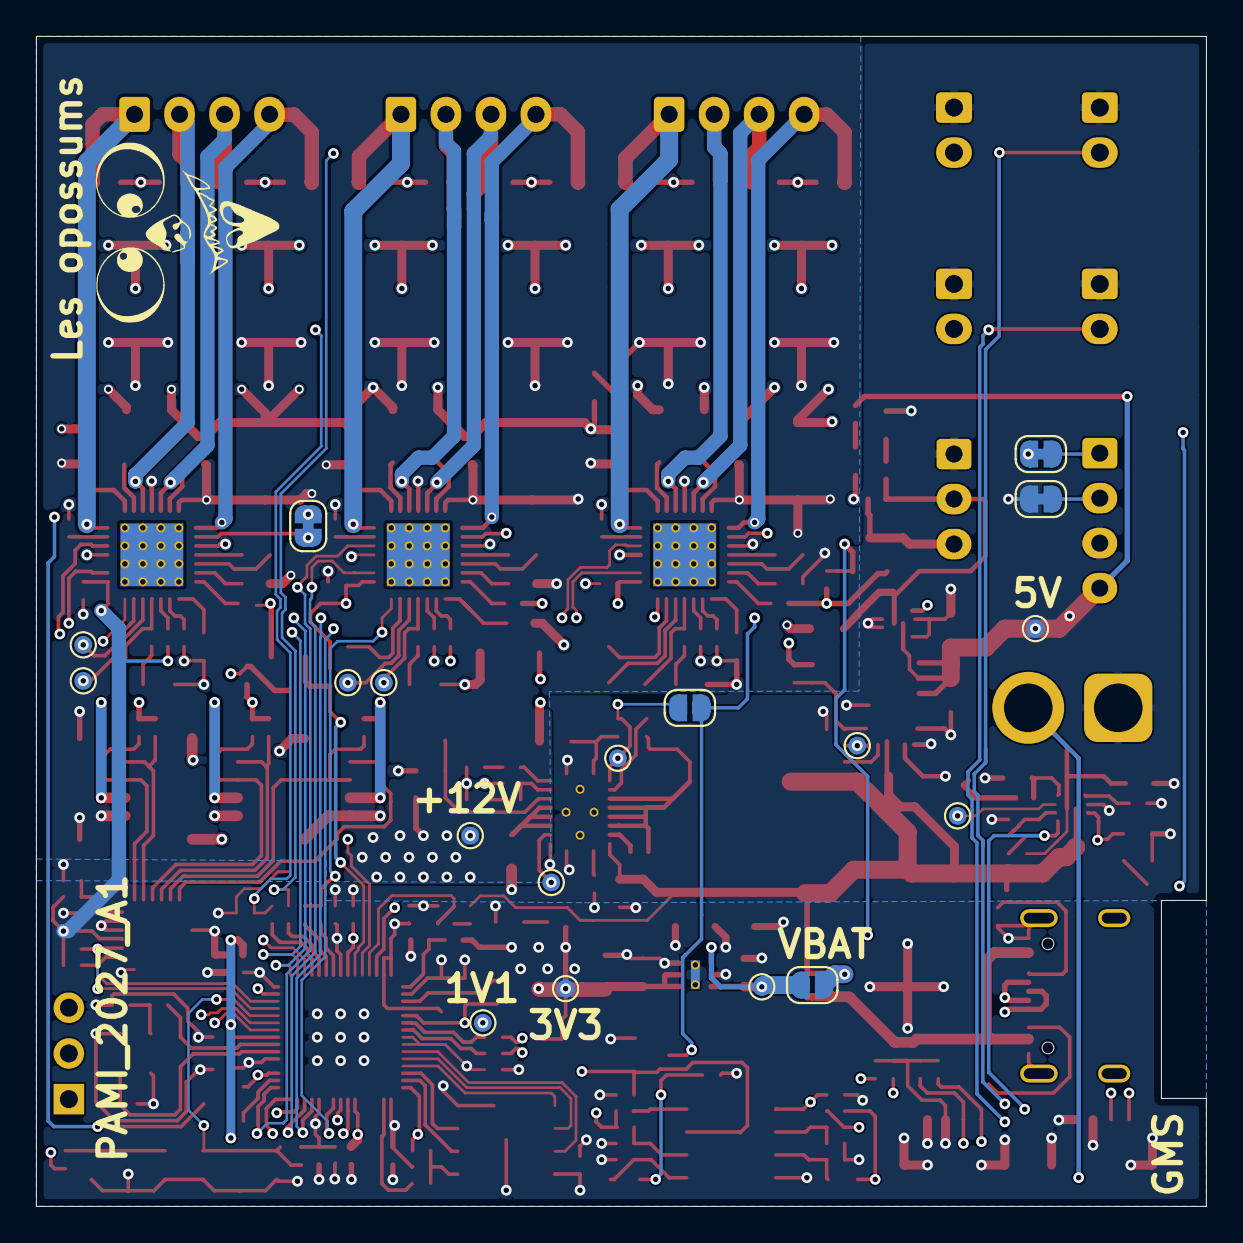
[picture p27: board PAMI_2027_A1.kicad_pcb from below]

Board: 4 copper layers, 65.0 x 65.0 mm, 248 parts (18 on the bottom side), 160 nets.
